Avanger2512/macropad/cad/compact/accessories/rear_feet/previews/fusion-feet-assembly.png

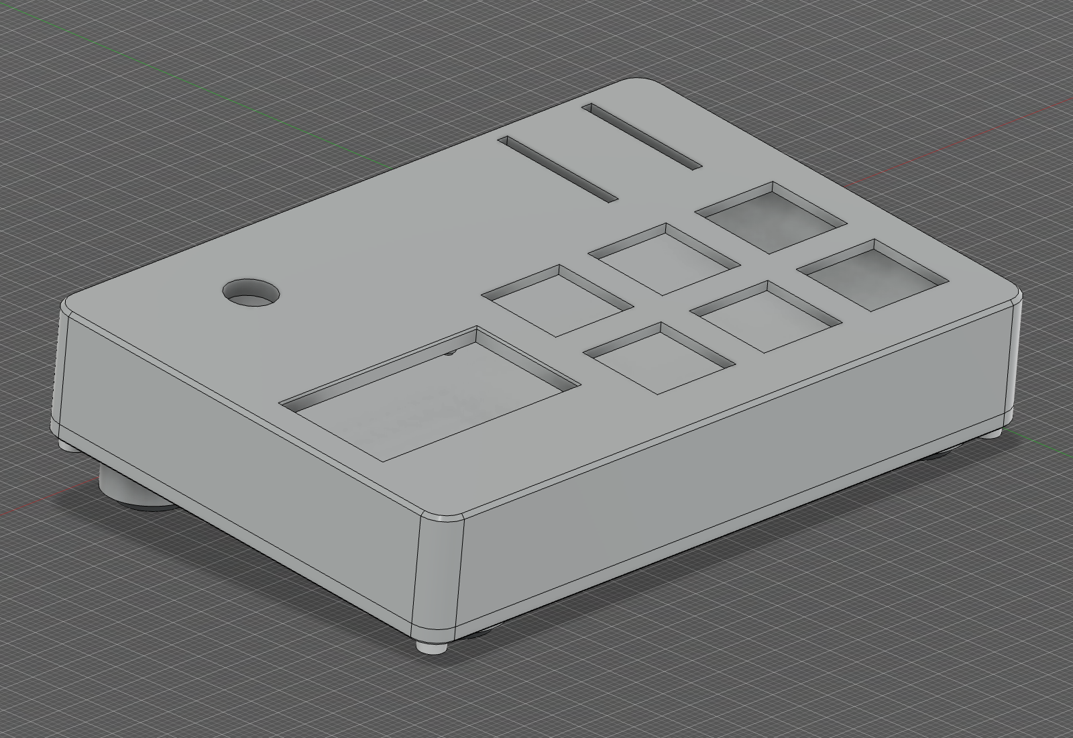
cad/compact/accessories/rear_feet/previews/fusion-feet-assembly.png
