Avanger2512/macropad/cad/compact/accessories/rear_feet/previews/front_foot_20261023T095841Z.png

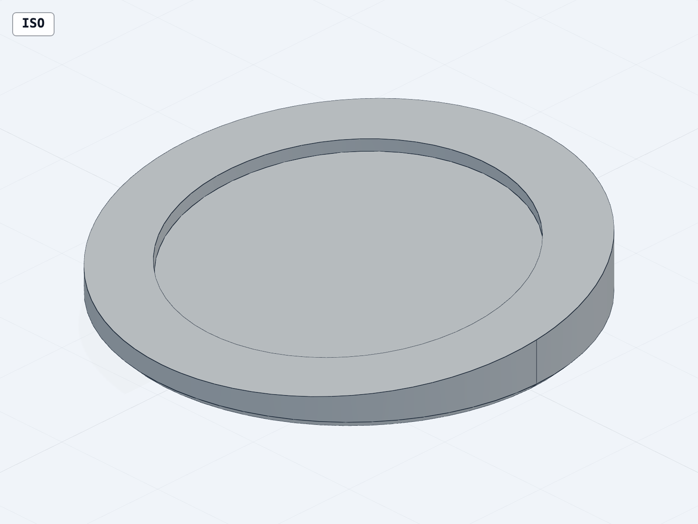
cad/compact/accessories/rear_feet/previews/front_foot_20261023T095841Z.png
