Avanger2512/macropad/cad/compact/accessories/rear_feet/previews/integrated_cover_under_20261023T105808Z.png

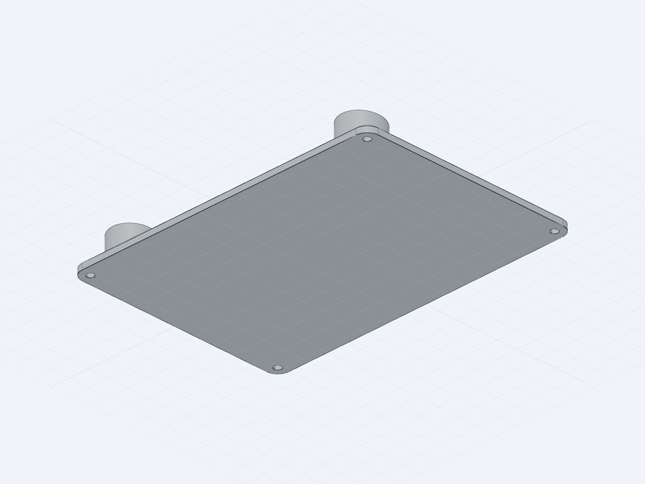
cad/compact/accessories/rear_feet/previews/integrated_cover_under_20261023T105808Z.png
