Avanger2512/macropad/cad/compact/c2/previews/c2-bottom_cover_20261022T102748Z.png

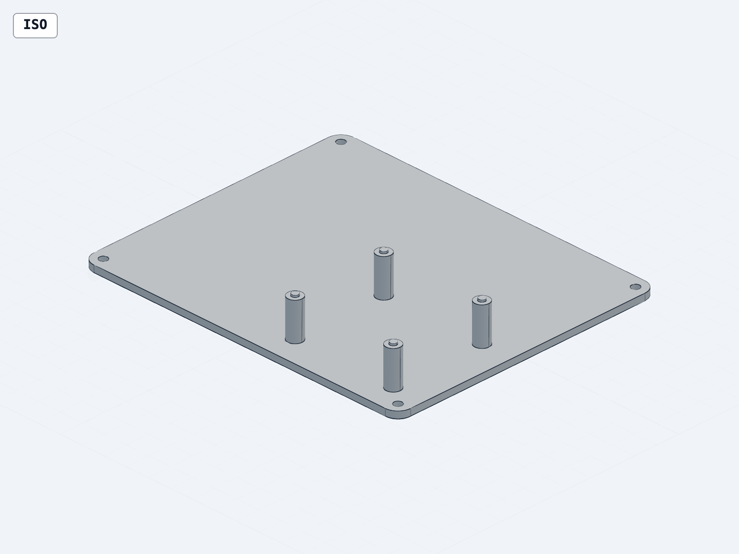
cad/compact/c2/previews/c2-bottom_cover_20261022T102748Z.png
