Avanger2512/macropad/cad/compact/c2/previews/c2-mcu_cradle_20261022T102748Z.png

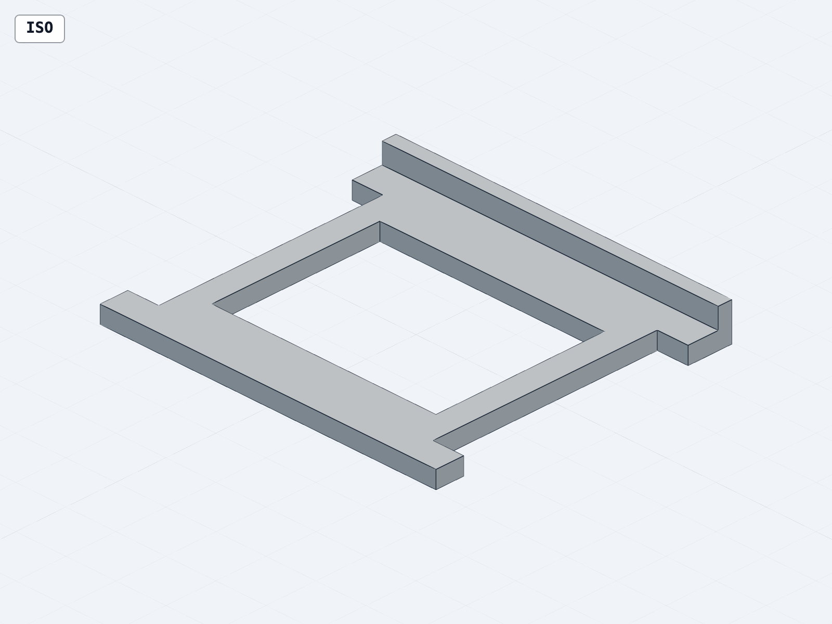
cad/compact/c2/previews/c2-mcu_cradle_20261022T102748Z.png
