Avanger2512/macropad/cad/compact/c3/previews/c3-bottom_cover_20261022T103931Z.png

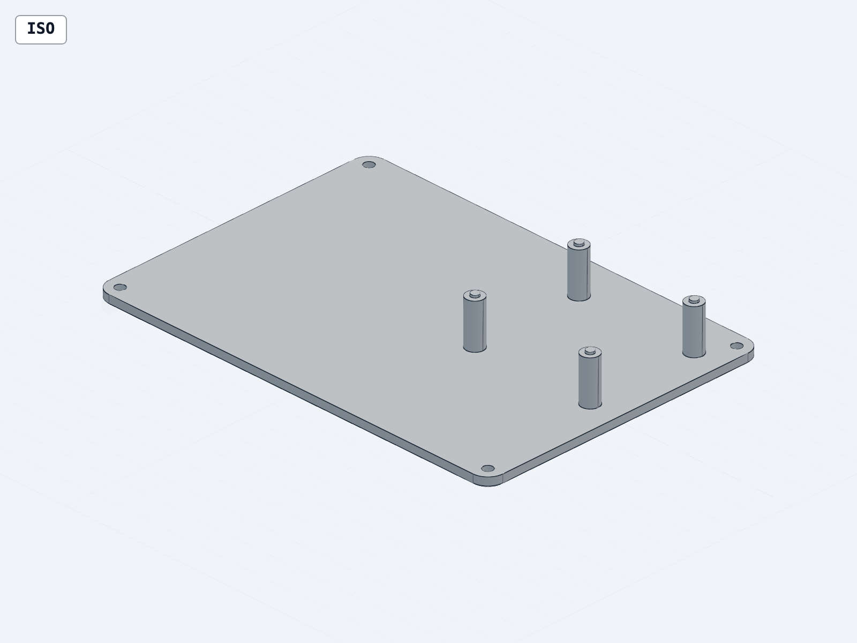
cad/compact/c3/previews/c3-bottom_cover_20261022T103931Z.png
