Avanger2512/macropad/cad/compact/c3/previews/c3-top_shell_20261022T103931Z.png

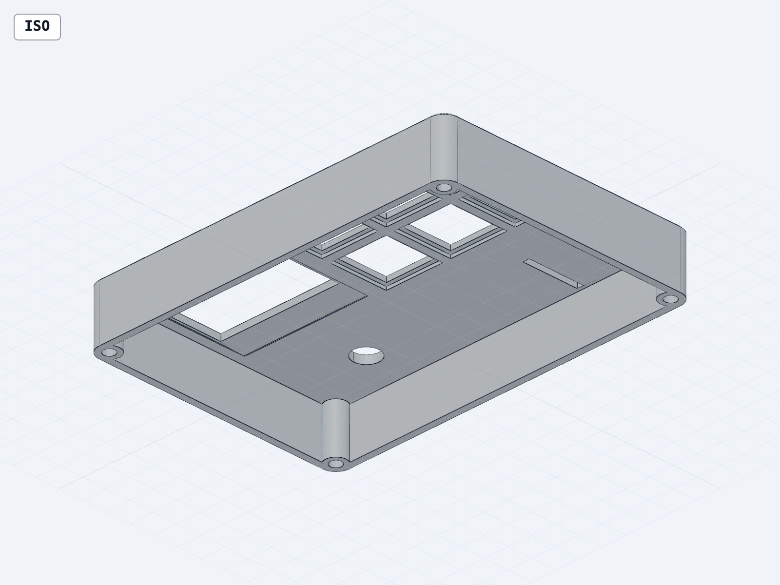
cad/compact/c3/previews/c3-top_shell_20261022T103931Z.png
