Avanger2512/macropad/cad/compact/c4/previews/c4-compact_model_20261022T130254Z.png

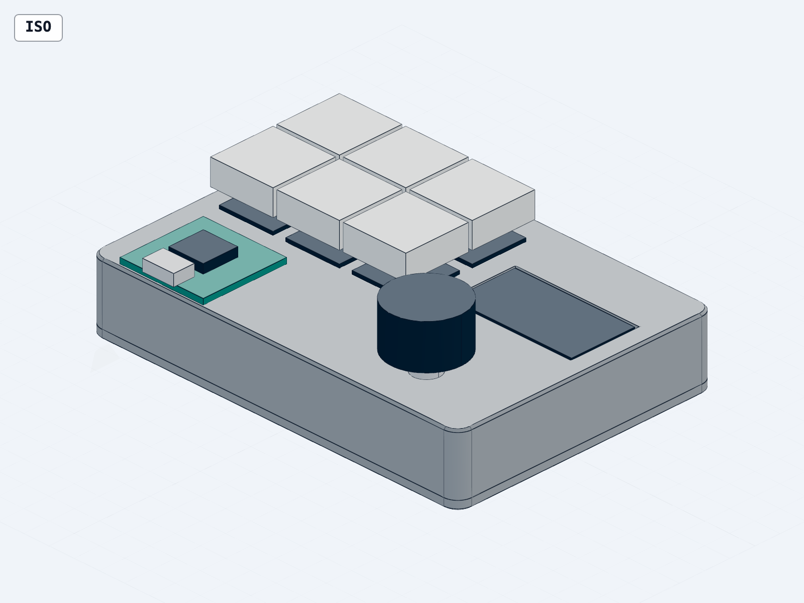
cad/compact/c4/previews/c4-compact_model_20261022T130254Z.png
