Avanger2512/macropad/cad/compact/c4/previews/c4-fusion-oled-mounts.png

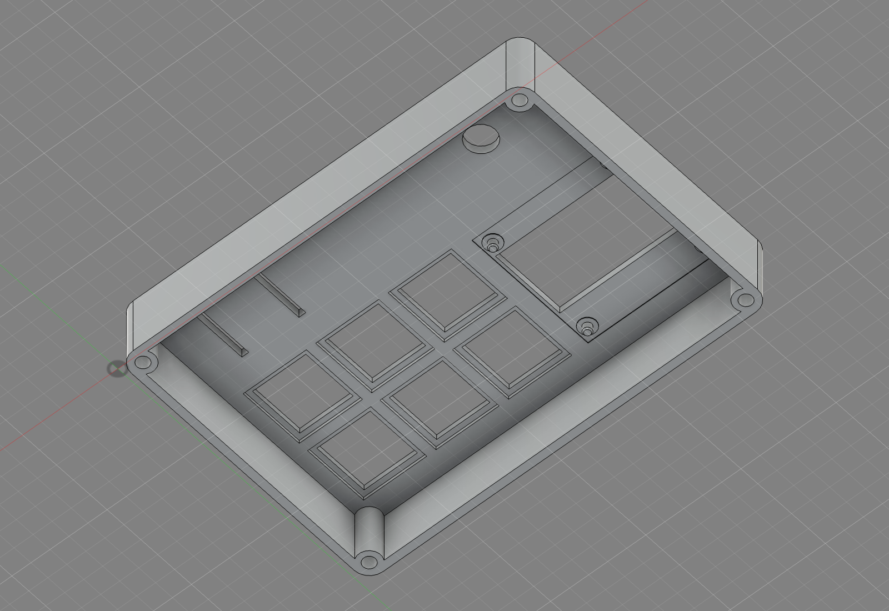
cad/compact/c4/previews/c4-fusion-oled-mounts.png
