Avanger2512/macropad/cad/compact/c4/previews/c4-mx-fit_20261022T130124Z.png

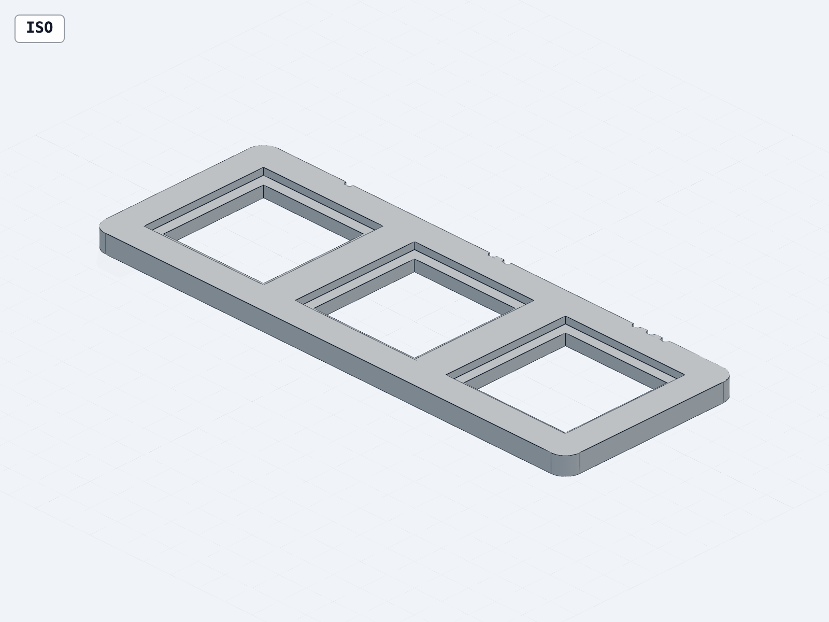
cad/compact/c4/previews/c4-mx-fit_20261022T130124Z.png
