Avanger2512/macropad/cad/compact/c5/previews/top_20261023T114638Z.png

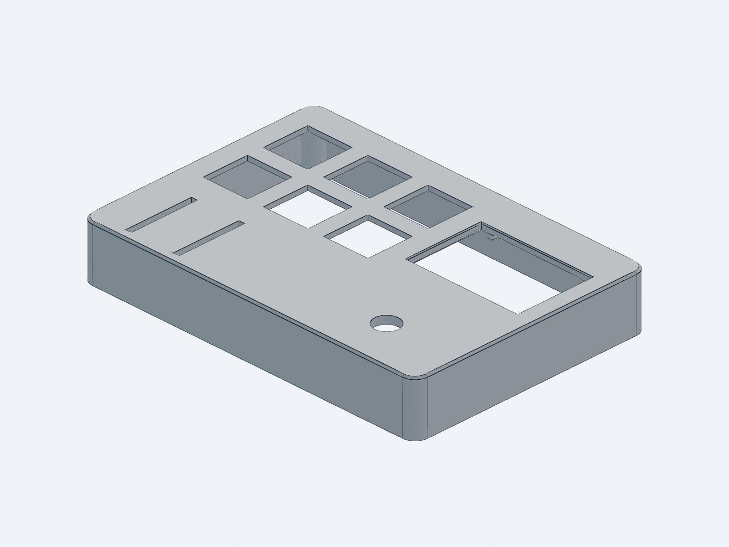
cad/compact/c5/previews/top_20261023T114638Z.png
