Avanger2512/macropad/cad/compact/previews/c1-front_20261022T092727Z.png

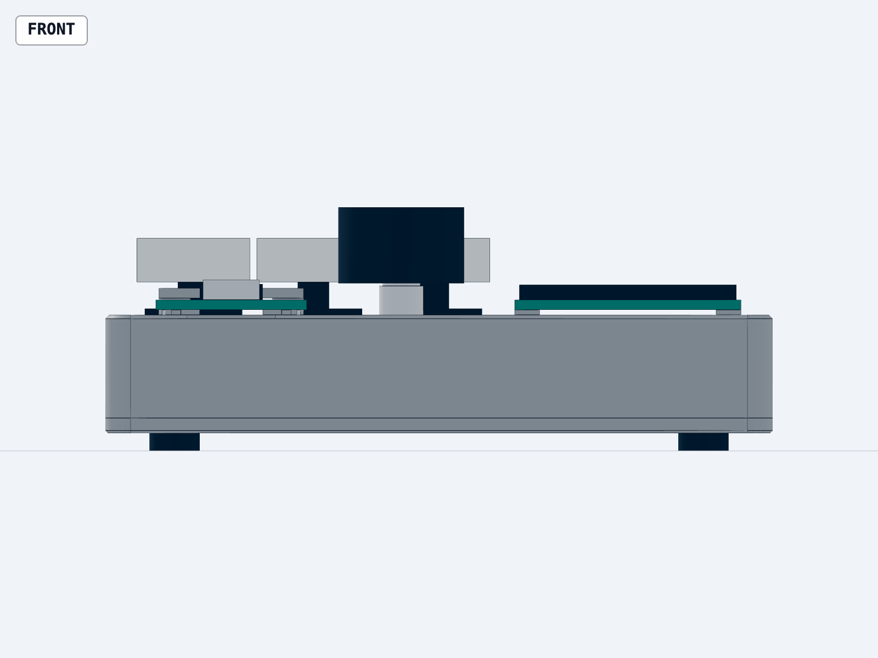
cad/compact/previews/c1-front_20261022T092727Z.png
