Avanger2512/macropad/cad/compact/previews/c1-mcu-cradle_20261022T093428Z.png

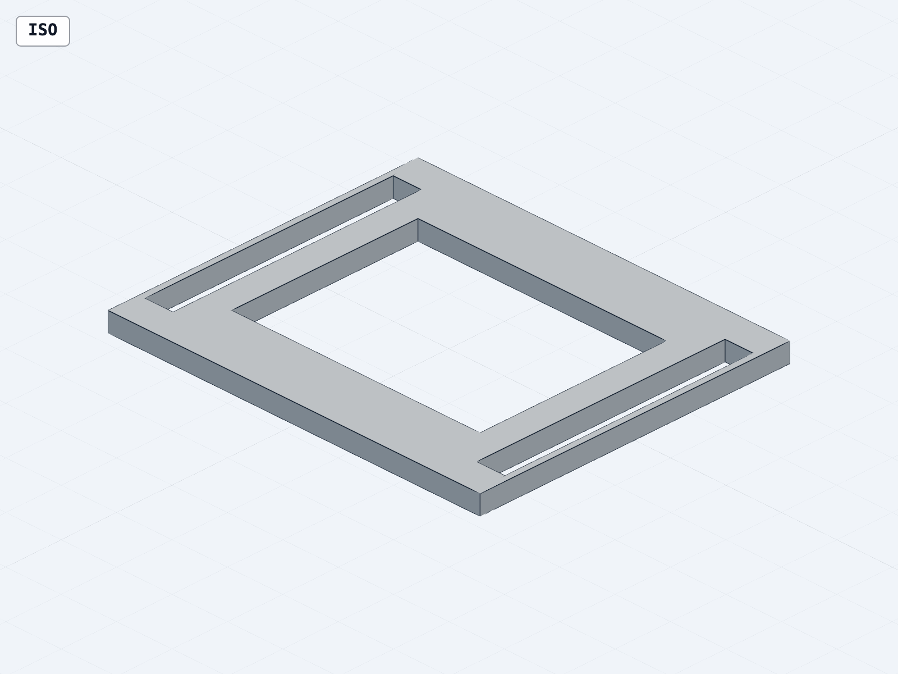
cad/compact/previews/c1-mcu-cradle_20261022T093428Z.png
