Avanger2512/macropad/cad/compact/previews/c1-oled-fusion-pins.png

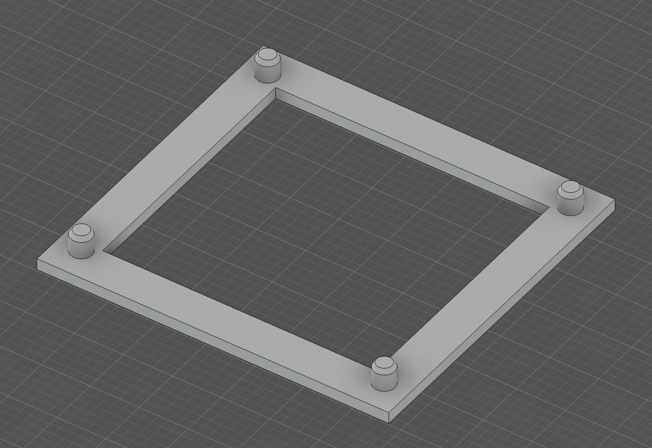
cad/compact/previews/c1-oled-fusion-pins.png
