Avanger2512/macropad/cad/compact/previews/c1-oled-pins-top_20261022T100858Z.png

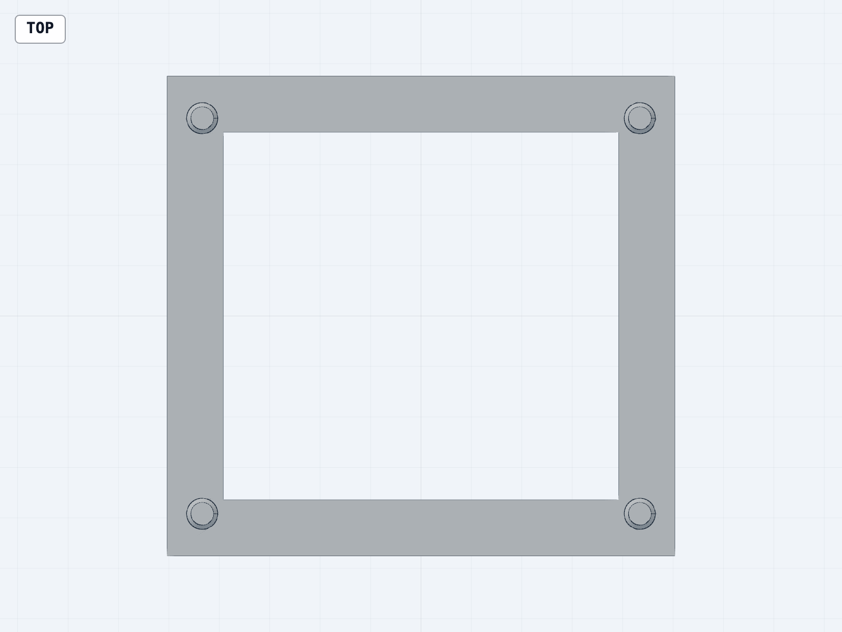
cad/compact/previews/c1-oled-pins-top_20261022T100858Z.png
