Avanger2512/macropad/cad/compact/previews/c1-opposite_20261022T092727Z.png

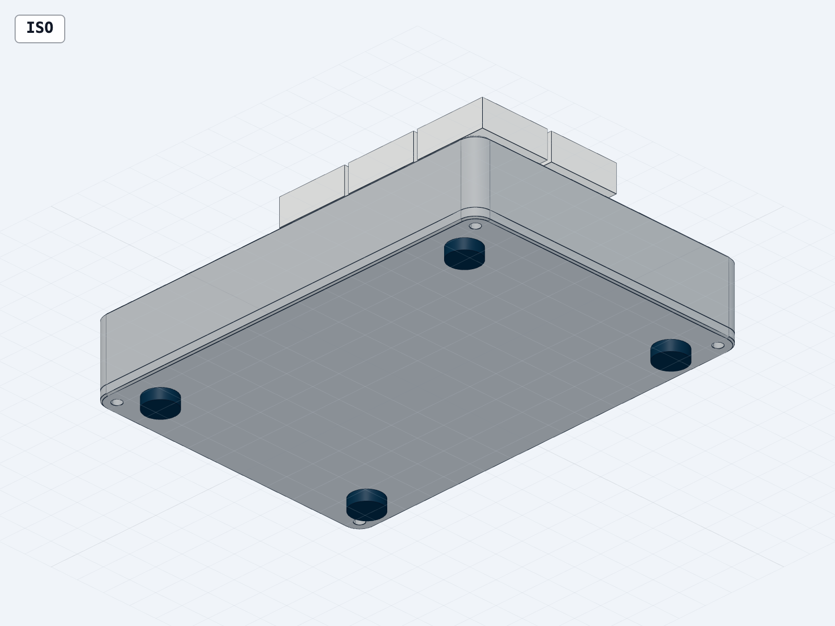
cad/compact/previews/c1-opposite_20261022T092727Z.png
