Avanger2512/macropad/cad/fusion/exports/carrier-v4-top.png

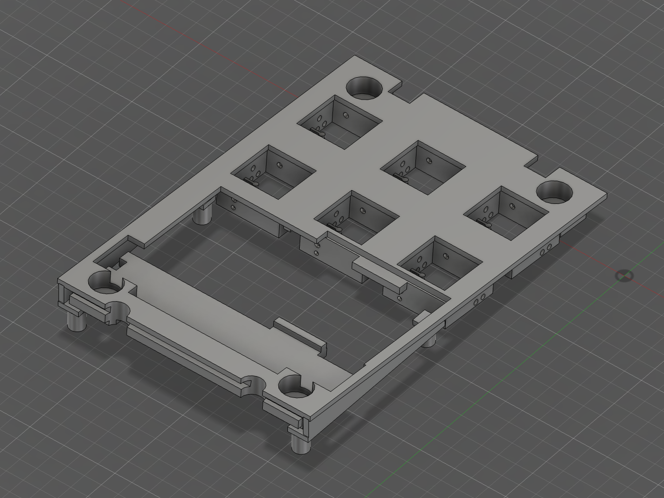
cad/fusion/exports/carrier-v4-top.png
