Avanger2512/macropad/cad/fusion/exports/carrier-v4-underneath.png

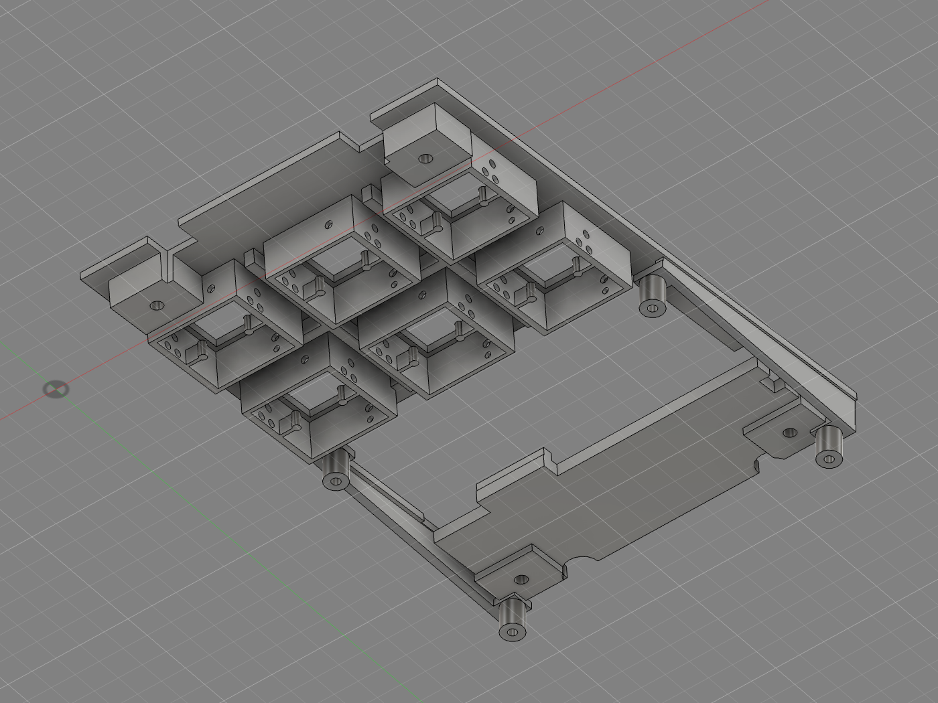
cad/fusion/exports/carrier-v4-underneath.png
