Avanger2512/macropad/cad/fusion/exports/compact-v2-receiver.png

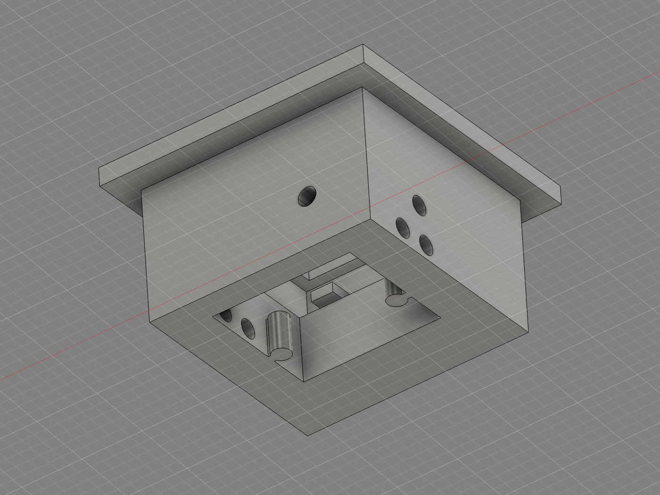
cad/fusion/exports/compact-v2-receiver.png
