Avanger2512/macropad/cad/fusion/exports/compact-v3-lid.png

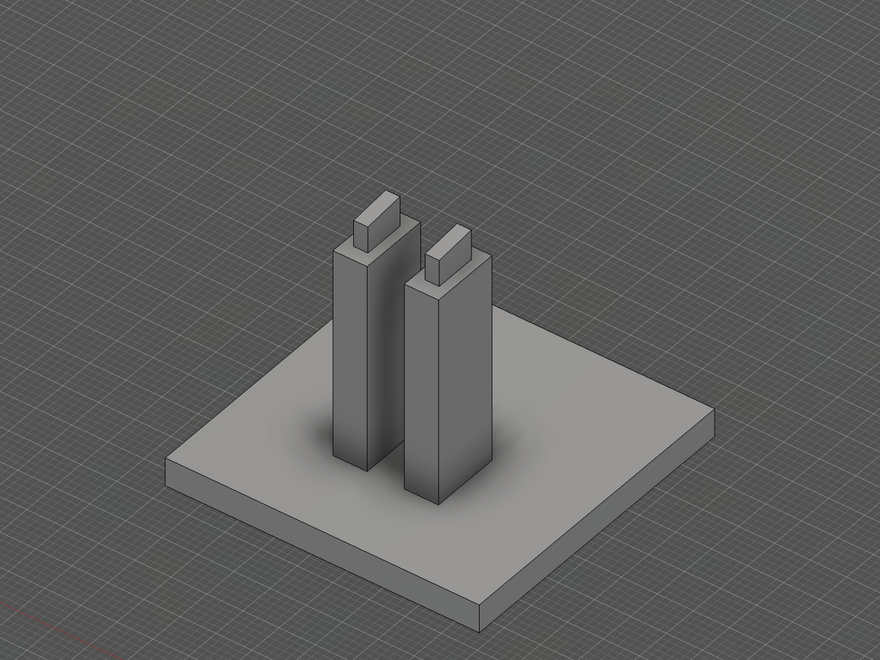
cad/fusion/exports/compact-v3-lid.png
