Avanger2512/macropad/cad/fusion/exports/compact-v3-receiver.png

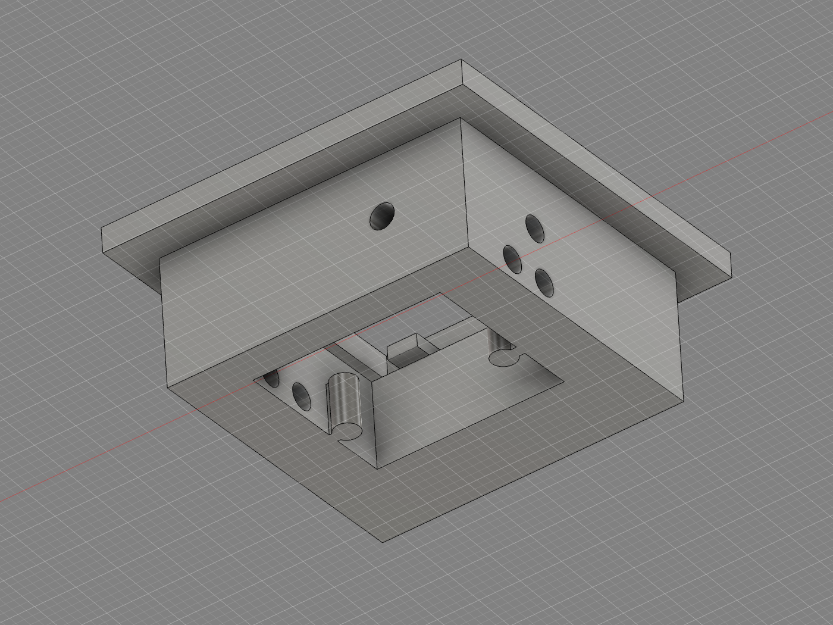
cad/fusion/exports/compact-v3-receiver.png
