Avanger2512/macropad/cad/fusion/exports/compact-v4-hotswap.png

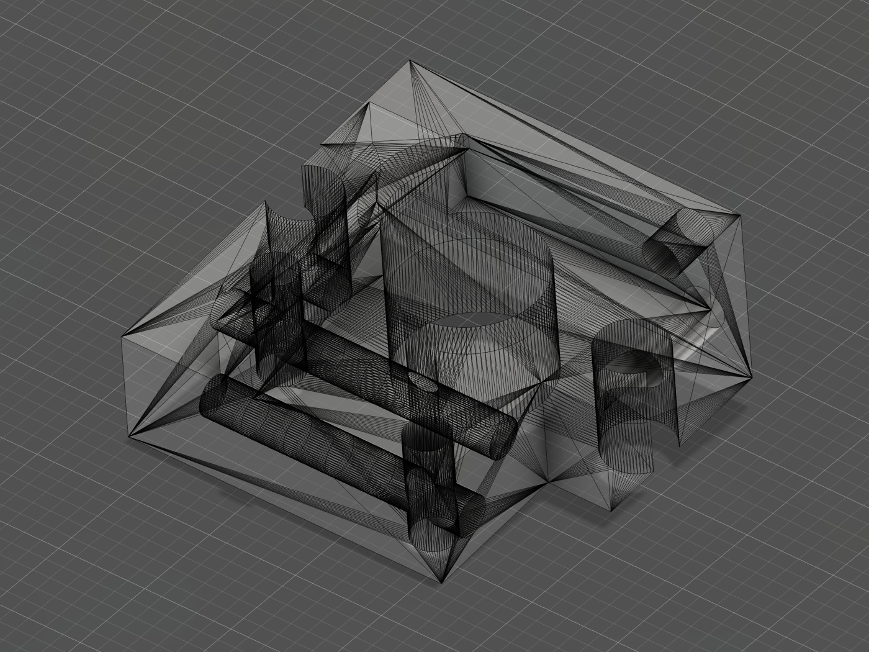
cad/fusion/exports/compact-v4-hotswap.png
