Avanger2512/macropad/cad/fusion/exports/compact-v4-receiver.png

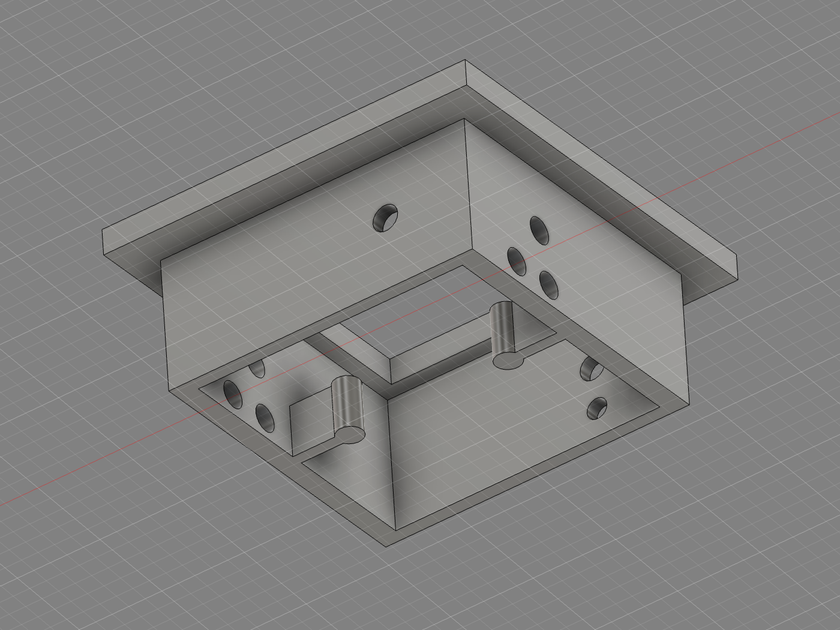
cad/fusion/exports/compact-v4-receiver.png
