Avanger2512/macropad/cad/fusion/exports/cover-mounts-v7-interior.png

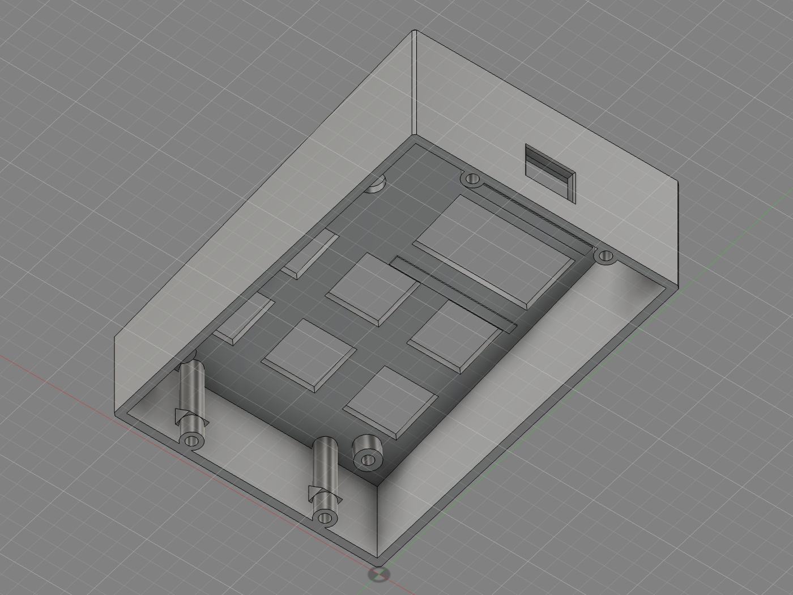
cad/fusion/exports/cover-mounts-v7-interior.png
