Avanger2512/macropad/cad/fusion/exports/enclosure-v6-bottom.png

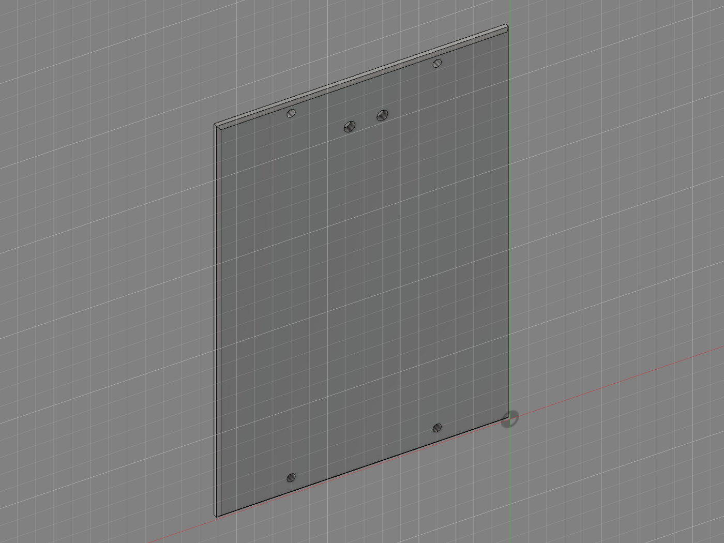
cad/fusion/exports/enclosure-v6-bottom.png
