Avanger2512/macropad/cad/fusion/exports/enclosure-v6-rear.png

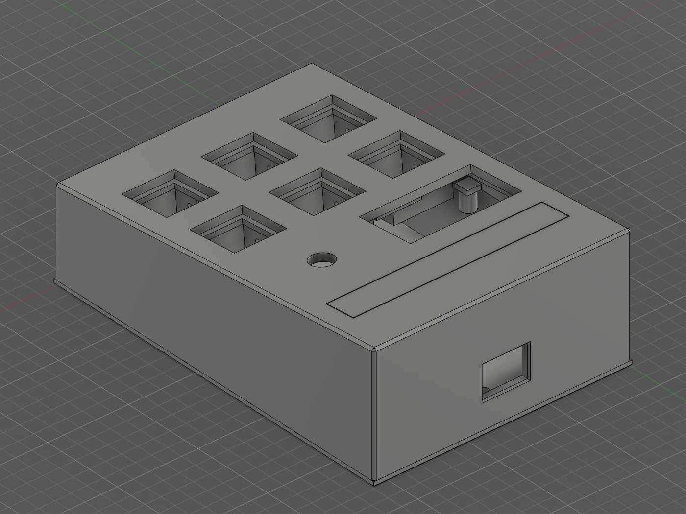
cad/fusion/exports/enclosure-v6-rear.png
