Avanger2512/macropad/cad/fusion/exports/macropad-draft-iso.png

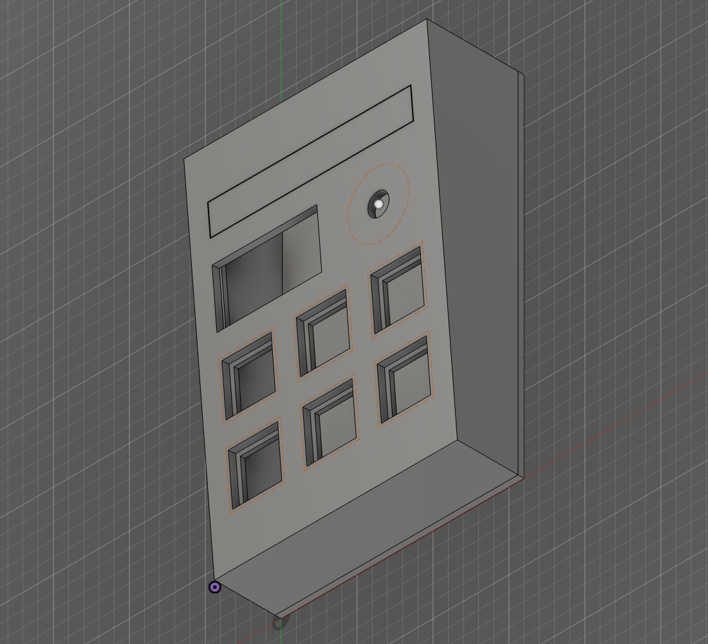
cad/fusion/exports/macropad-draft-iso.png
