Avanger2512/macropad/cad/fusion/exports/macropad-iteration2-carrier.png

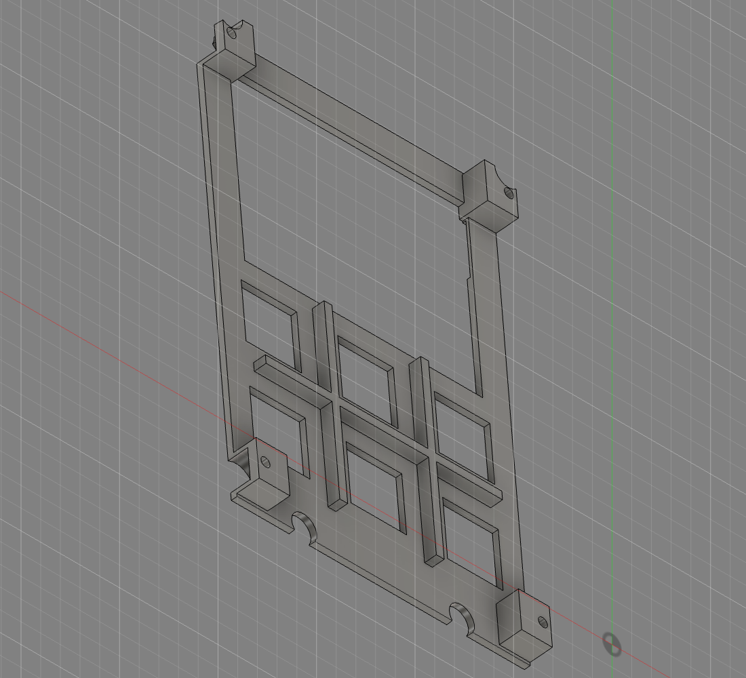
cad/fusion/exports/macropad-iteration2-carrier.png
