Avanger2512/macropad/cad/fusion/exports/macropad-iteration2-interior.png

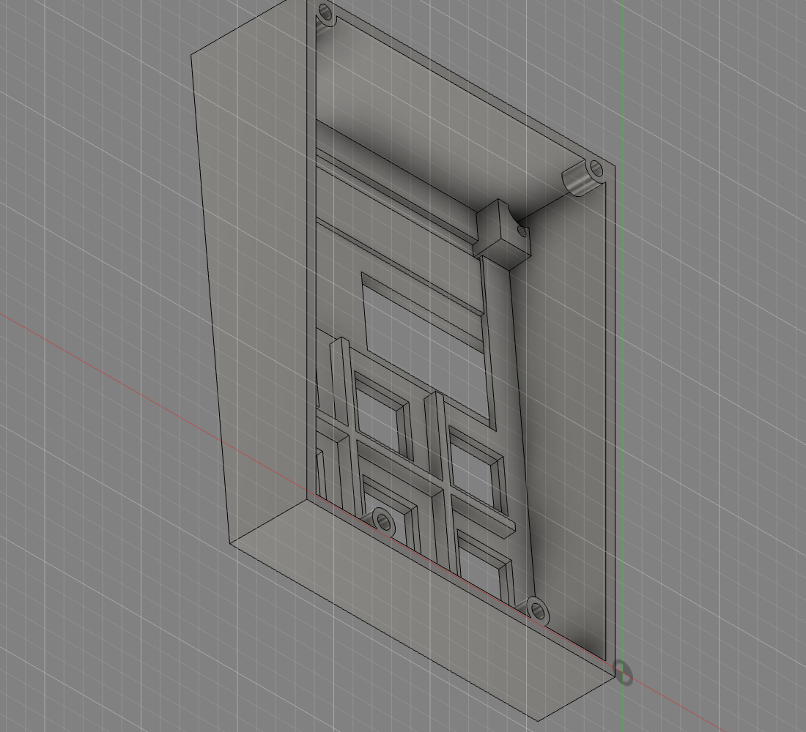
cad/fusion/exports/macropad-iteration2-interior.png
