Avanger2512/macropad/cad/fusion/exports/macropad-iteration3-interior.png

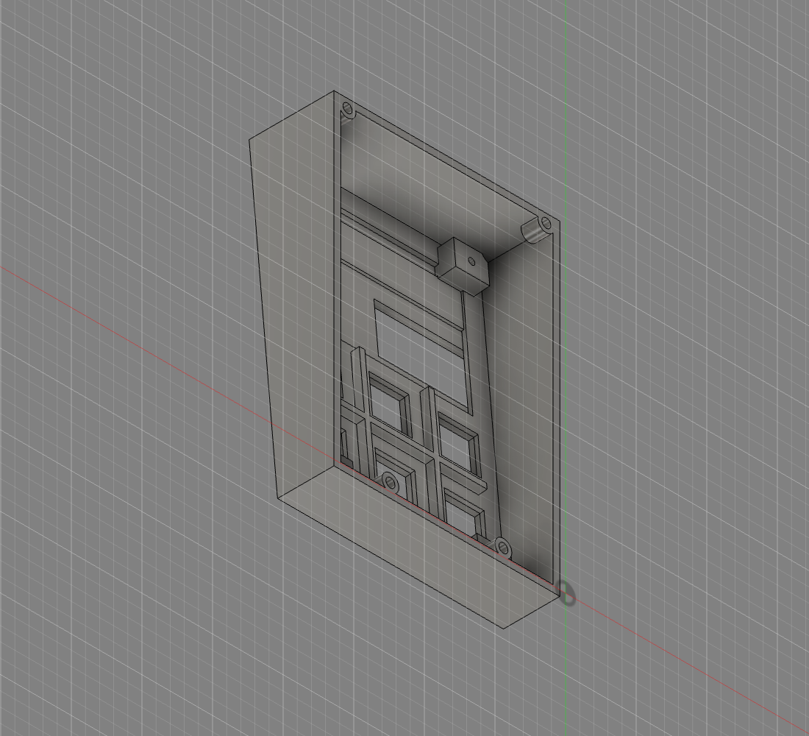
cad/fusion/exports/macropad-iteration3-interior.png
