Avanger2512/macropad/cad/fusion/exports/macropad-pcb-layout.png

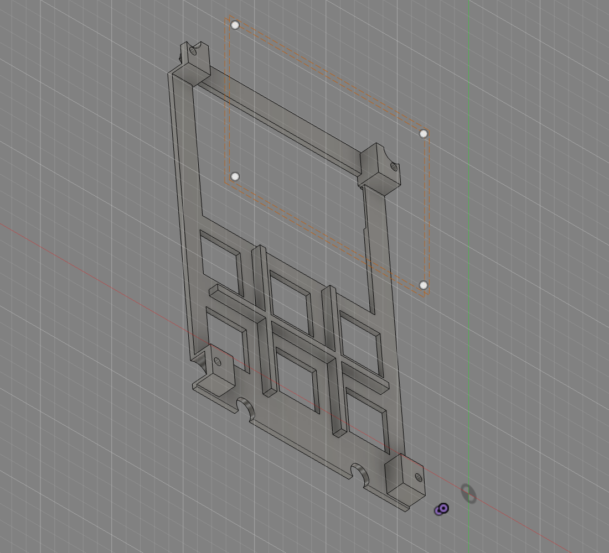
cad/fusion/exports/macropad-pcb-layout.png
