Avanger2512/macropad/cad/fusion/exports/macropad-pcb-mount-revision.png

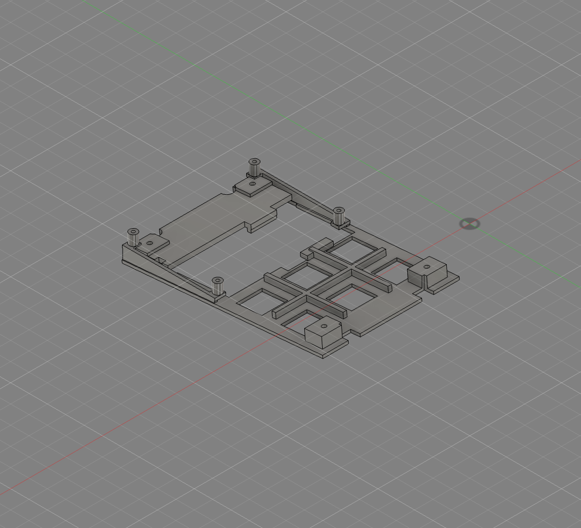
cad/fusion/exports/macropad-pcb-mount-revision.png
