Avanger2512/macropad/cad/fusion/exports/macropad-switch-retention-carrier.png

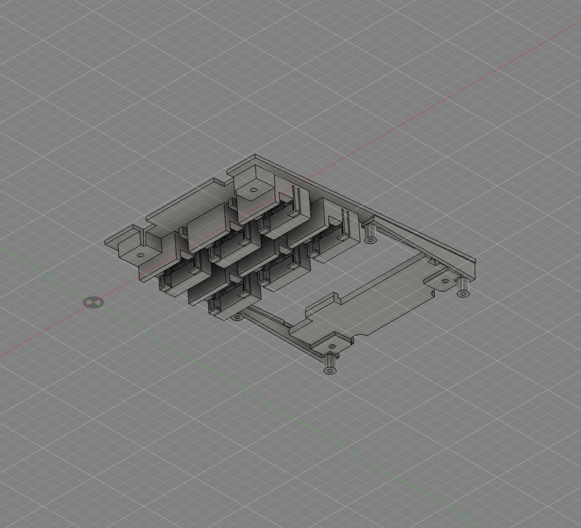
cad/fusion/exports/macropad-switch-retention-carrier.png
