Avanger2512/macropad/cad/fusion/exports/macropad-switch-retention-lid.png

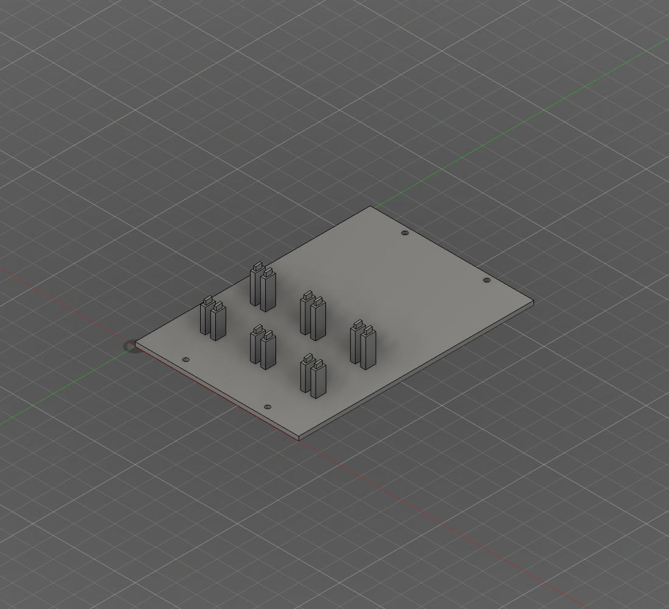
cad/fusion/exports/macropad-switch-retention-lid.png
