Avanger2512/macropad/cad/fusion/exports/through-pin-v5-holder.png

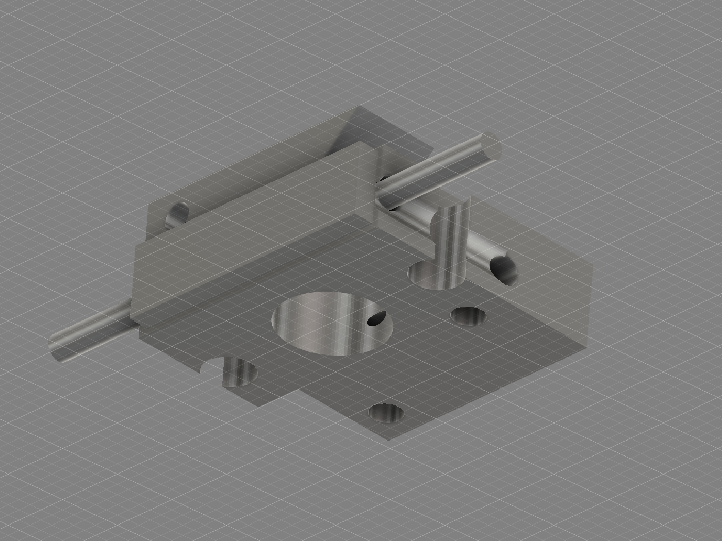
cad/fusion/exports/through-pin-v5-holder.png
