Avanger2512/macropad/cad/compact/accessories/rear_feet/bottom_cover_with_feet.step

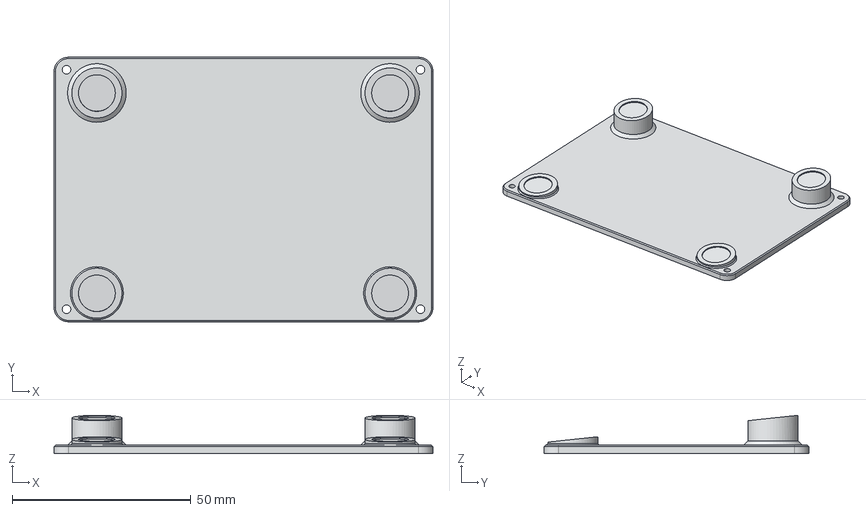
[picture p48: CAD file, 2026-10-24]
cad/compact/accessories/rear_feet/bottom_cover_with_feet.step
106.0 x 74.0 x 10.7 mm
