Avanger2512/macropad/cad/compact/c2/bottom_cover.step

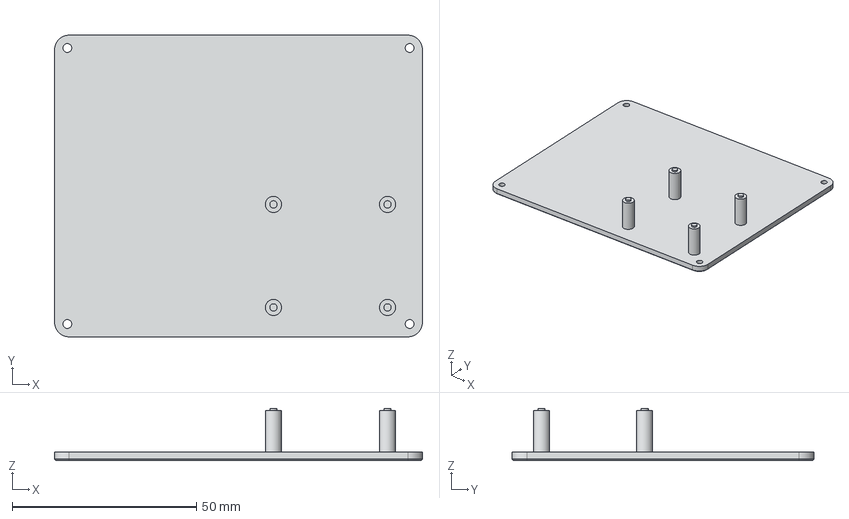
[picture p49: CAD file, 2026-10-22]
cad/compact/c2/bottom_cover.step
100.0 x 82.0 x 14.2 mm
