Avanger2512/macropad/cad/compact/c3/oled_cradle.step

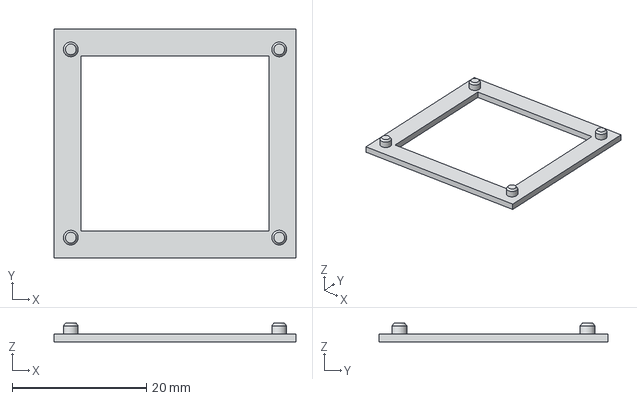
[picture p50: CAD file, 2026-10-22]
cad/compact/c3/oled_cradle.step
36.0 x 34.0 x 2.80 mm
