Avanger2512/macropad/cad/compact/c4/top_shell.step

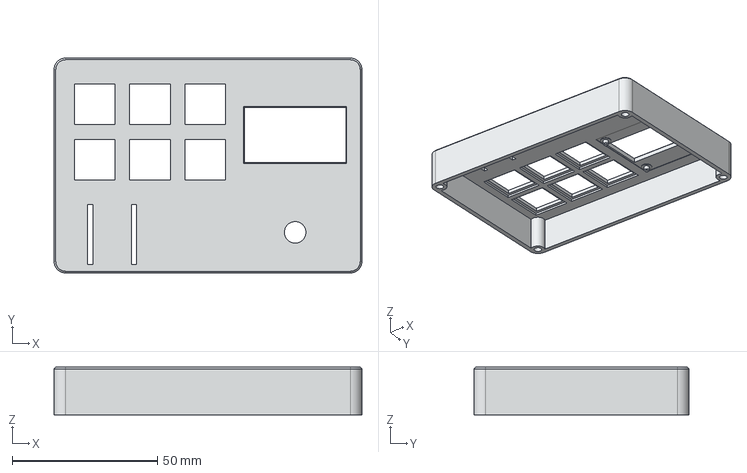
[picture p51: CAD file, 2026-10-22]
cad/compact/c4/top_shell.step
106.0 x 74.0 x 16.4 mm
