Avanger2512/macropad/cad/fusion/exports/upper_shell_finish_v6.step

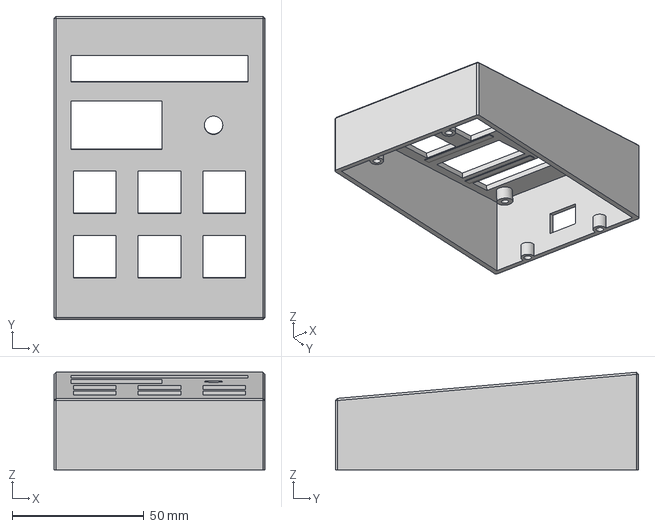
[picture p52: CAD file, 2026-10-20]
cad/fusion/exports/upper_shell_finish_v6.step
80.0 x 115.0 x 37.0 mm
