Avanger2512/macropad/cad/hotswap_mx__compact.stl

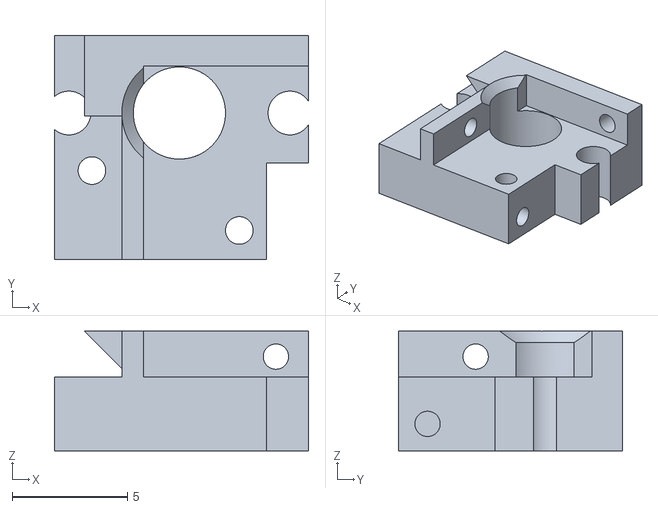
[picture p53: CAD file, 2026-10-13]
cad/hotswap_mx__compact.stl
11.0 x 9.75 x 5.20
