Avanger2512/macropad/cad/compact/accessories/rear_feet/rear_foot.step

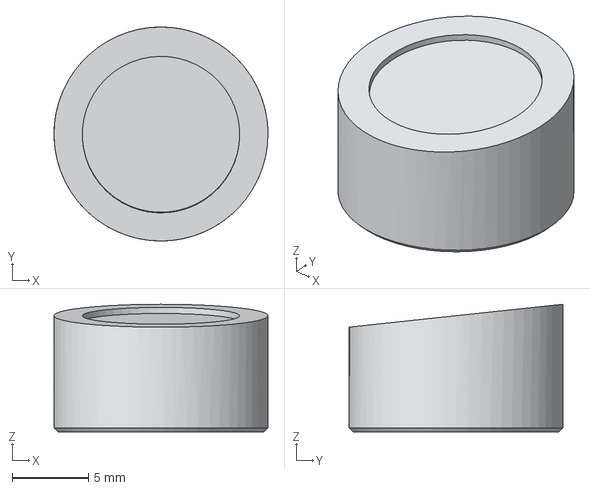
[picture p54: CAD file, 2026-10-24]
cad/compact/accessories/rear_feet/rear_foot.step
14.0 x 14.0 x 8.34 mm
