Avanger2512/macropad/cad/compact/oled_cradle.step

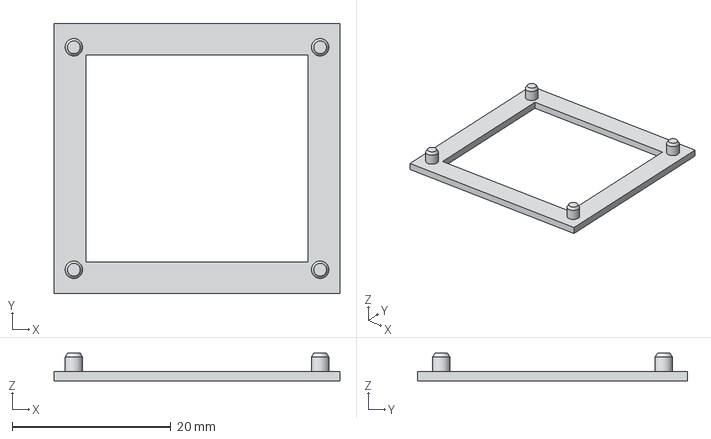
[picture p56: CAD file, 2026-10-22]
cad/compact/oled_cradle.step
36.0 x 34.0 x 3.50 mm
