Avanger2512/macropad/cad/fusion/exports/hotswap_mx_through_pin_v5_native.stl

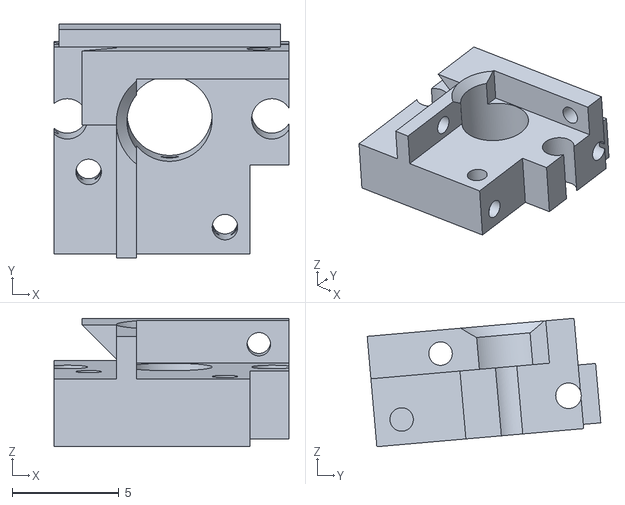
[picture p57: CAD file, 2026-10-20]
cad/fusion/exports/hotswap_mx_through_pin_v5_native.stl
11.0 x 11.0 x 6.03
