Avanger2512/macropad/cad/whotswap-MX-v2.3mf

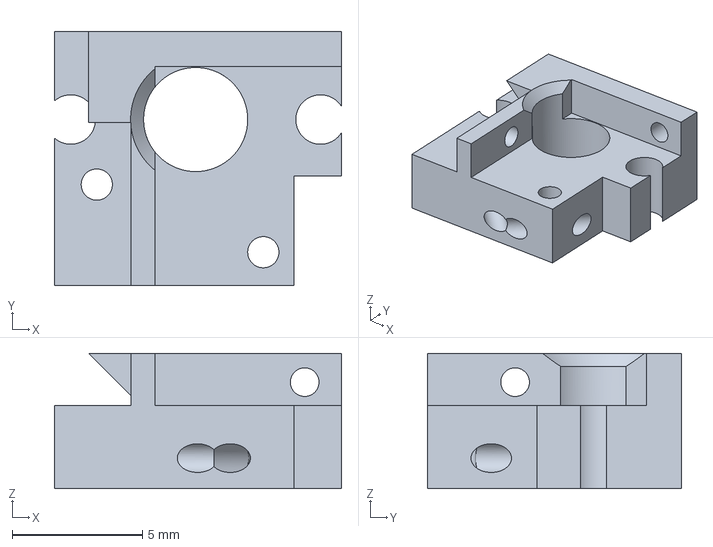
[picture p58: CAD file, 2026-10-12]
cad/whotswap-MX-v2.3mf
11.0 x 9.75 x 5.20 mm
