Avanger2512/macropad/cad/choc.stl

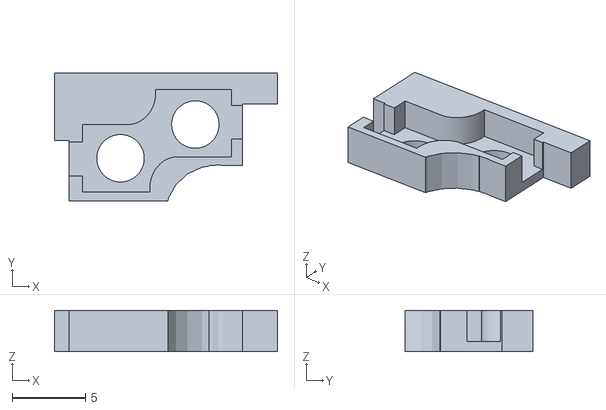
[picture p59: CAD file, 2026-10-12]
cad/choc.stl
15.2 x 8.70 x 2.80
