Avanger2512/macropad/cad/compact/accessories/rear_feet/fitted_case.step

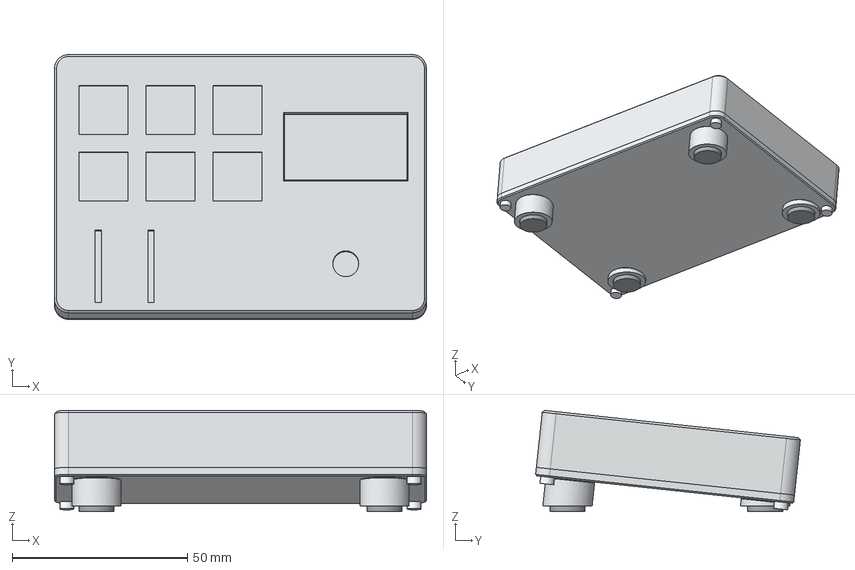
[picture p60: CAD file, 2026-10-24]
cad/compact/accessories/rear_feet/fitted_case.step
106.0 x 75.5 x 28.8 mm
REFERENCE existing C4 top_shell
REFERENCE existing C4 bottom_cover
Rear raised wedge foot - adhesive mount D10 pad left
Rear raised wedge foot - adhesive mount D10 pad right
Front low wedge foot - adhesive mount D10 pad left
Front low wedge foot - adhesive mount D10 pad right
REFERENCE rubber pad - user measured D10 x2 x 4
REFERENCE existing screw head D4 x2 x 4
