Avanger2512/macropad/cad/compact/c2/mcu_cradle.step

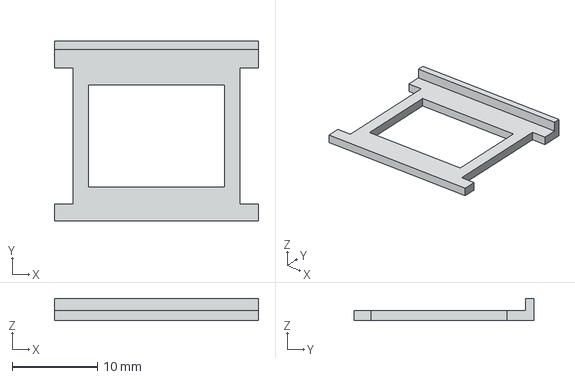
[picture p61: CAD file, 2026-10-22]
cad/compact/c2/mcu_cradle.step
24.0 x 21.1 x 2.60 mm
