Avanger2512/macropad/cad/compact/c3/bottom_cover.step

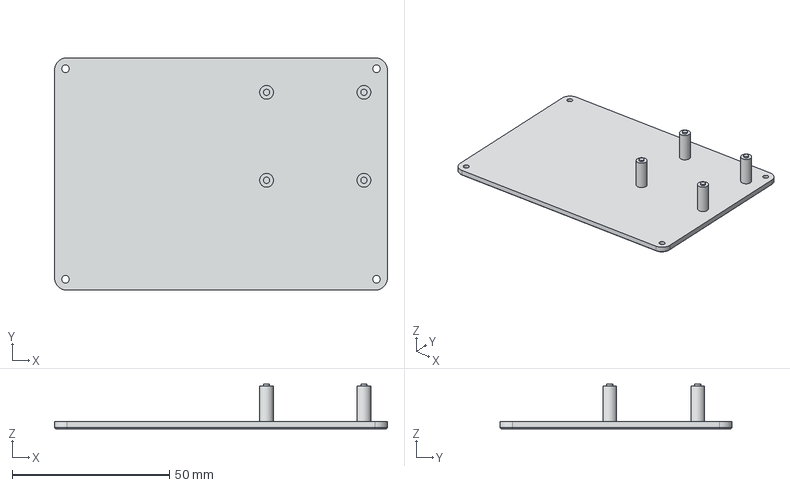
[picture p62: CAD file, 2026-10-22]
cad/compact/c3/bottom_cover.step
106.0 x 74.0 x 14.2 mm
