Avanger2512/macropad/cad/compact/c4/bottom_cover.step

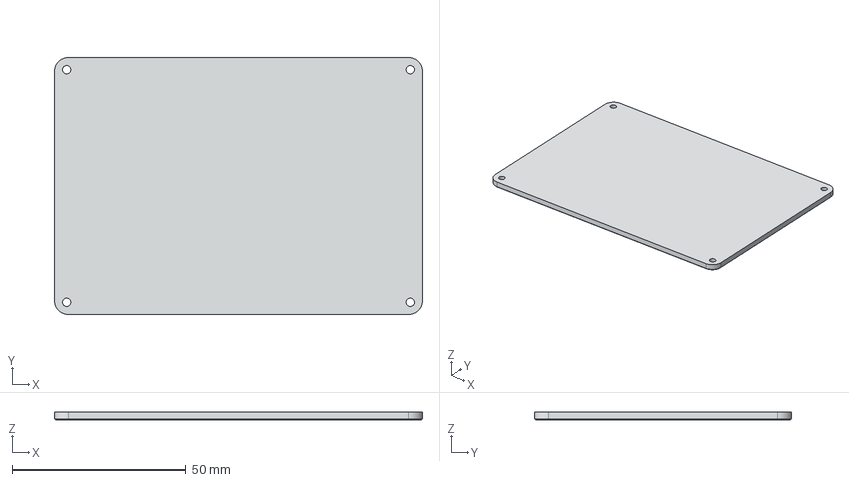
[picture p63: CAD file, 2026-10-22]
cad/compact/c4/bottom_cover.step
106.0 x 74.0 x 2.40 mm
