Avanger2512/macropad/cad/compact/compact_model.step

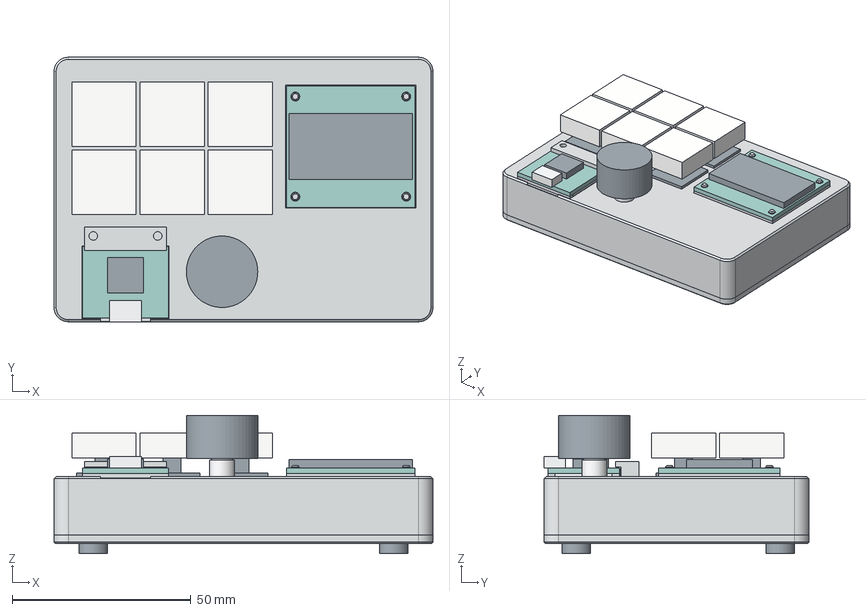
[picture p64: CAD file, 2026-10-22]
cad/compact/compact_model.step
106.0 x 74.0 x 38.7 mm
C1 top shell - provisional electronics seats
C1 removable lower cover - M2 clearance
C1 removable MCU strap - edge clearance provisional
C1 OLED cradle - 31x28 locating pins diameter 2.2
C1 replaceable MCU cradle - provisional
REFERENCE MX 1 - assumed depth
REFERENCE cap 1 - 18 mm measured footprint
REFERENCE switch 1 solder pin x 2
REFERENCE MX 2 - assumed depth
REFERENCE cap 2 - 18 mm measured footprint
REFERENCE switch 2 solder pin x 2
REFERENCE MX 3 - assumed depth
REFERENCE cap 3 - 18 mm measured footprint
REFERENCE switch 3 solder pin x 2
REFERENCE MX 4 - assumed depth
REFERENCE cap 4 - 18 mm measured footprint
REFERENCE switch 4 solder pin x 2
REFERENCE MX 5 - assumed depth
REFERENCE cap 5 - 18 mm measured footprint
REFERENCE switch 5 solder pin x 2
REFERENCE MX 6 - assumed depth
REFERENCE cap 6 - 18 mm measured footprint
REFERENCE switch 6 solder pin x 2
REFERENCE OLED PCB - measured holes 31x28 diameter 2.5
REFERENCE OLED glass - offset provisional
REFERENCE ESP32-S3 SuperMini - provisional outline
REFERENCE ESP32 components - provisional
REFERENCE USB connector - provisional
REFERENCE MCU downward pins - provisional x 2
REFERENCE KY040 PCB - centered axis provisional
REFERENCE encoder body - assumed
REFERENCE measured encoder bushing diameter 7 length 7
REFERENCE encoder shaft - provisional
REFERENCE encoder knob - diameter provisional
REFERENCE rubber foot - effective height 2.8 x 4
