Avanger2512/macropad/cad/compact/accessories/rear_feet/feet_set.step

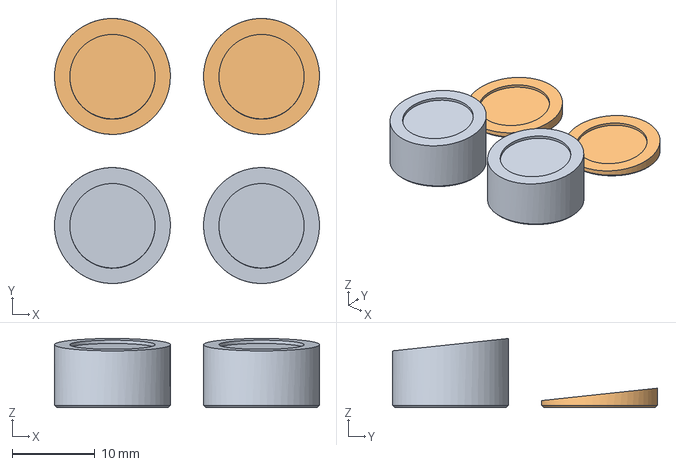
[picture p65: CAD file, 2026-10-24]
cad/compact/accessories/rear_feet/feet_set.step
32.0 x 32.0 x 8.34 mm
Rear raised wedge foot - adhesive mount D10 pad x 2
Front low wedge foot - adhesive mount D10 pad x 2
