Avanger2512/macropad/cad/compact/c2/top_shell.step

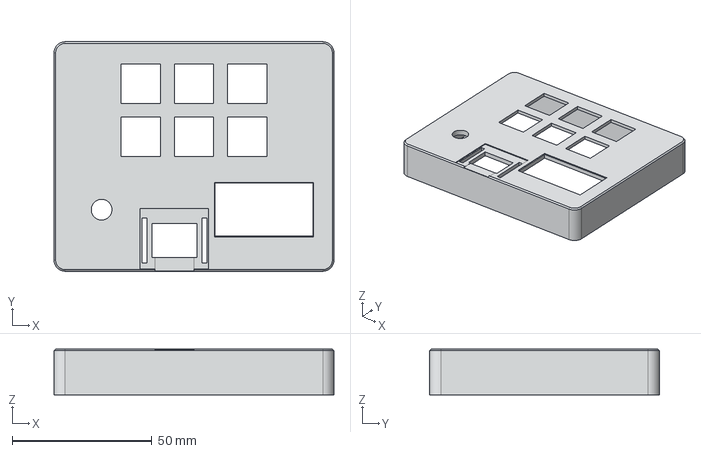
[picture p66: CAD file, 2026-10-22]
cad/compact/c2/top_shell.step
100.0 x 82.0 x 16.4 mm
