Avanger2512/macropad/cad/compact/c4/mx_coupon.step

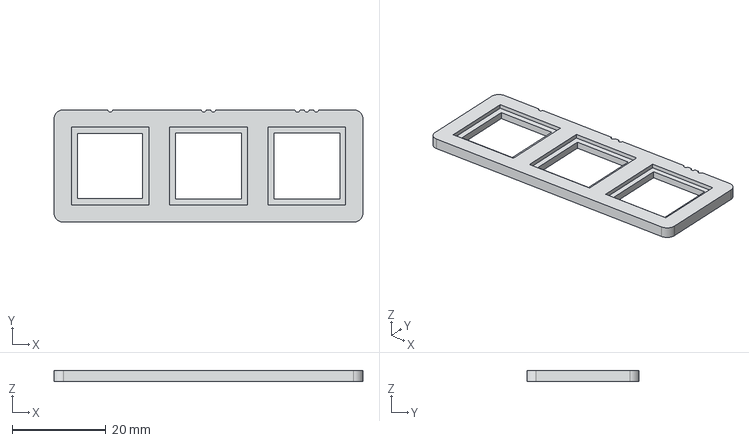
[picture p67: CAD file, 2026-10-22]
cad/compact/c4/mx_coupon.step
66.0 x 24.0 x 2.40 mm
