Avanger2512/macropad/cad/compact/mx_coupon.step

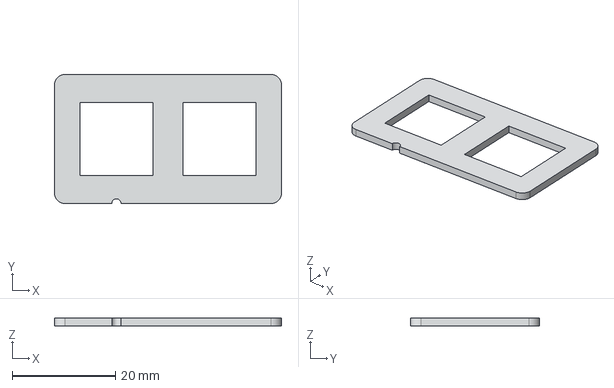
[picture p68: CAD file, 2026-10-22]
cad/compact/mx_coupon.step
44.0 x 25.0 x 1.50 mm
