Avanger2512/macropad/cad/fusion/exports/bottom_cover_finish_v6.step

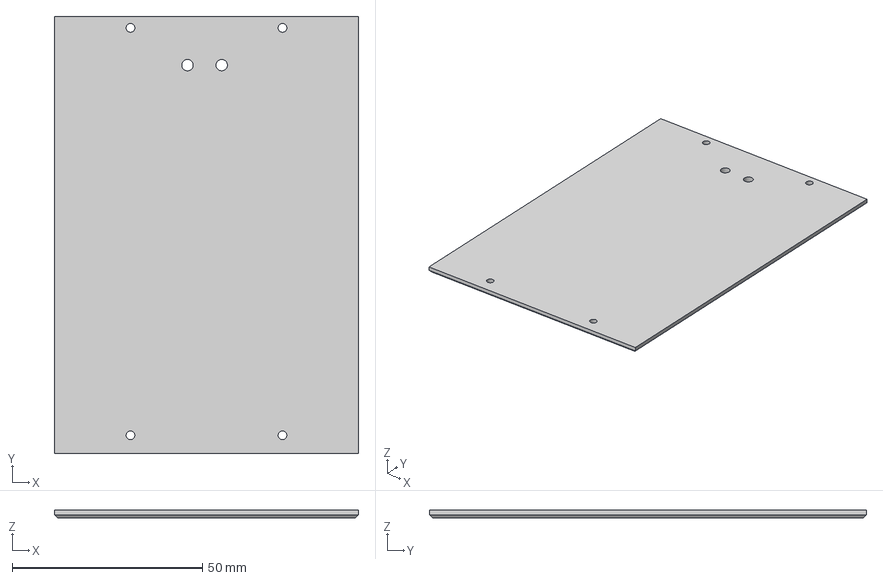
[picture p69: CAD file, 2026-10-20]
cad/fusion/exports/bottom_cover_finish_v6.step
80.0 x 115.0 x 2.00 mm
