Avanger2512/macropad/cad/MX.stl

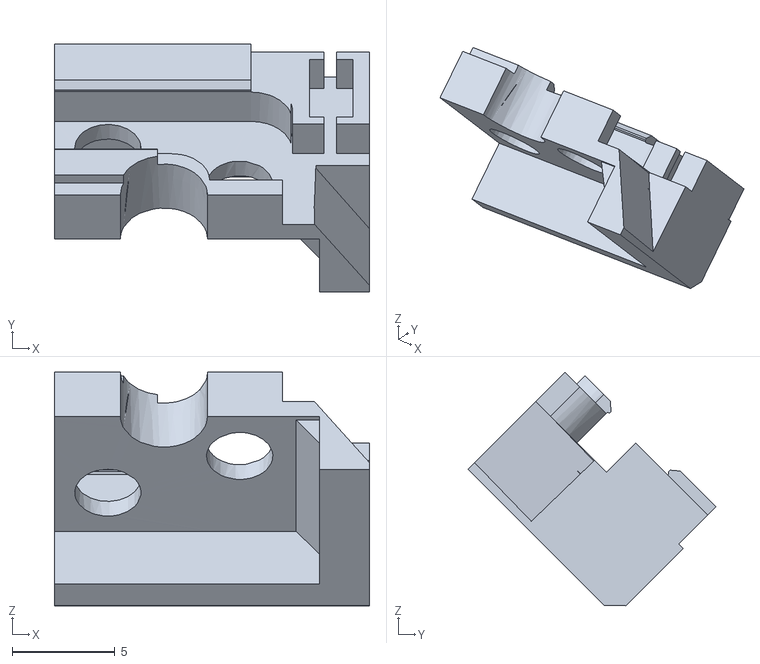
[picture p70: CAD file, 2026-10-12]
cad/MX.stl
15.4 x 12.1 x 11.4
