Avanger2512/macropad/cad/compact/accessories/rear_feet/front_foot.step

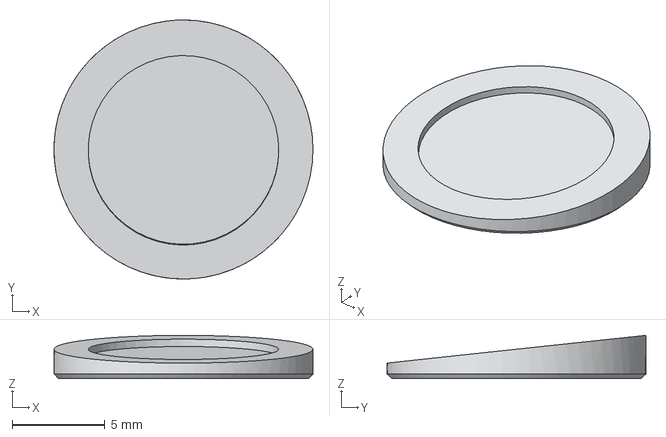
[picture p71: CAD file, 2026-10-24]
cad/compact/accessories/rear_feet/front_foot.step
14.0 x 14.0 x 2.34 mm
