Avanger2512/macropad/cad/compact/mcu_cradle.step

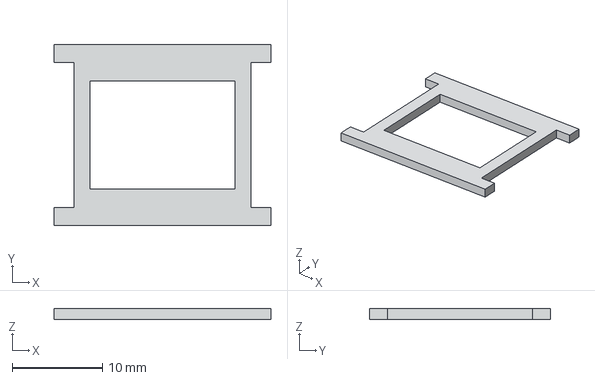
[picture p74: CAD file, 2026-10-22]
cad/compact/mcu_cradle.step
24.0 x 20.0 x 1.20 mm
