Avanger2512/macropad/cad/hotswap_mx__with_wing.stl

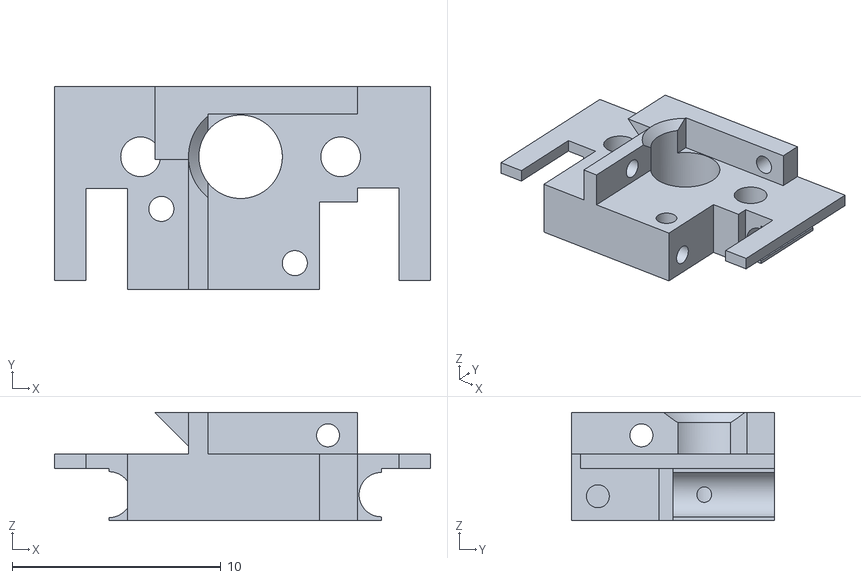
[picture p75: CAD file, 2026-10-12]
cad/hotswap_mx__with_wing.stl
18.0 x 9.75 x 5.20
