Avanger2512/macropad/cad/fusion/exports/middle_carrier_through_pin_v5_native.stl

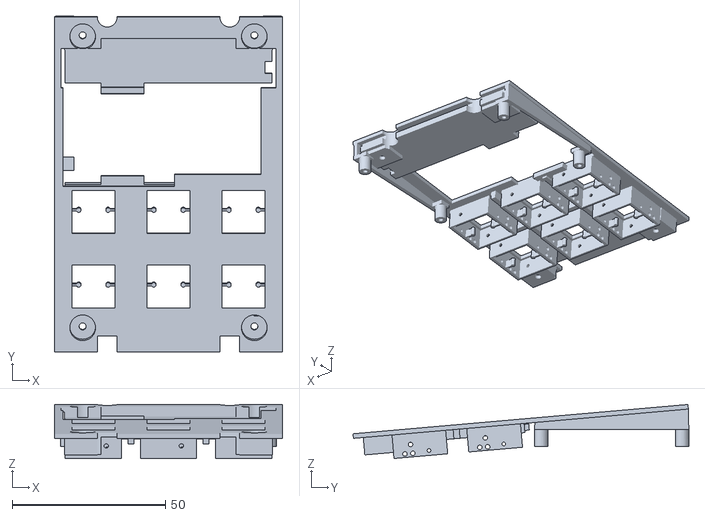
[picture p76: CAD file, 2026-10-20]
cad/fusion/exports/middle_carrier_through_pin_v5_native.stl
74.4 x 109.6 x 17.6
