Avanger2512/macropad/cad/print/Diffuser_Service_V8.stl

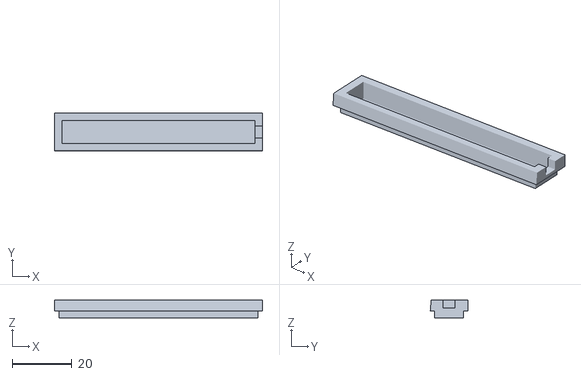
[picture p77: CAD file, 2026-10-20]
cad/print/Diffuser_Service_V8.stl
69.6 x 12.6 x 6.00
