Avanger2512/macropad/cad/compact/mcu_strap.step

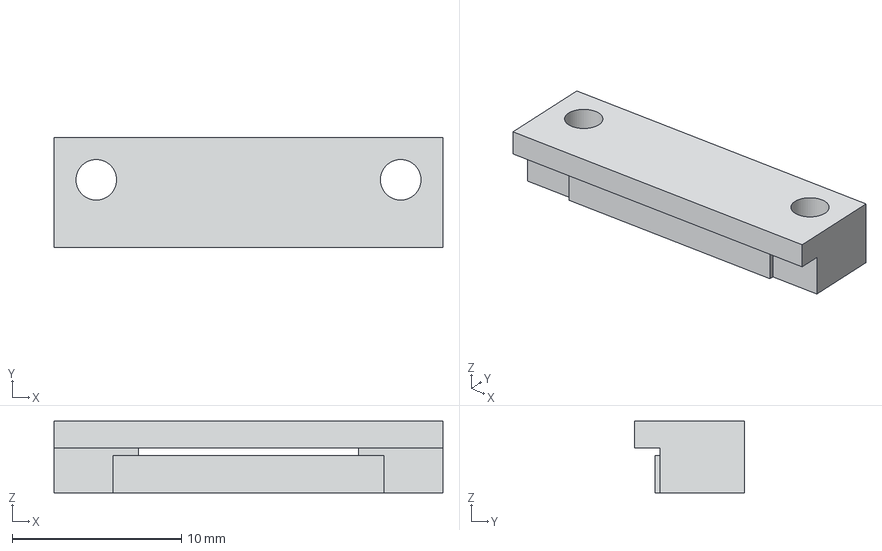
[picture p78: CAD file, 2026-10-22]
cad/compact/mcu_strap.step
23.0 x 6.50 x 4.25 mm
