Avanger2512/macropad/cad/print/MiddleCarrier_Through_Pin_V5.stl

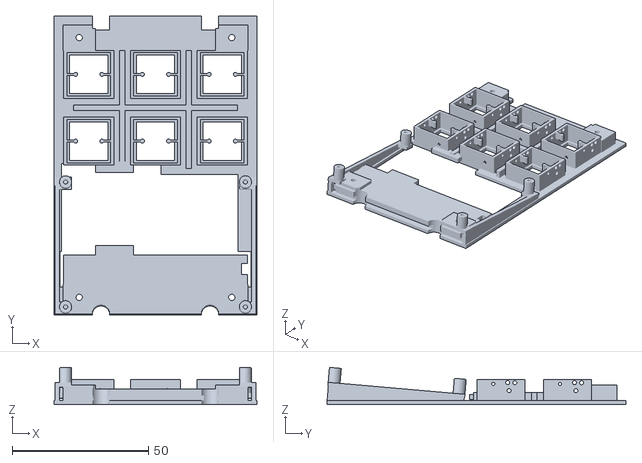
[picture p79: CAD file, 2026-10-20]
cad/print/MiddleCarrier_Through_Pin_V5.stl
74.4 x 109.7 x 13.7
