Avanger2512/macropad/cad/fusion/exports/switch_fit_coupon_through_pin_v5.step

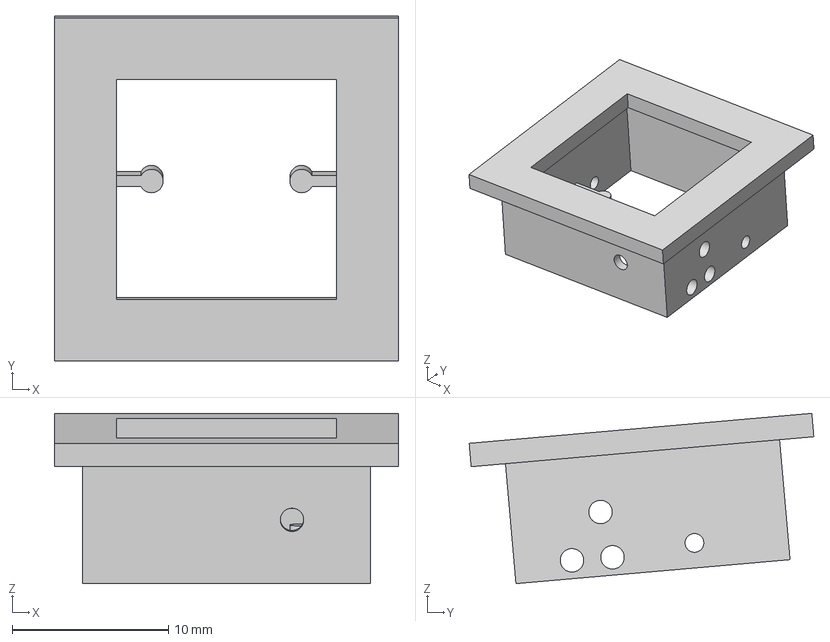
[picture p80: CAD file, 2026-10-20]
cad/fusion/exports/switch_fit_coupon_through_pin_v5.step
22.0 x 22.0 x 10.9 mm
