Avanger2512/macropad/cad/print/SwitchFitCoupon_Through_Pin_V5.stl

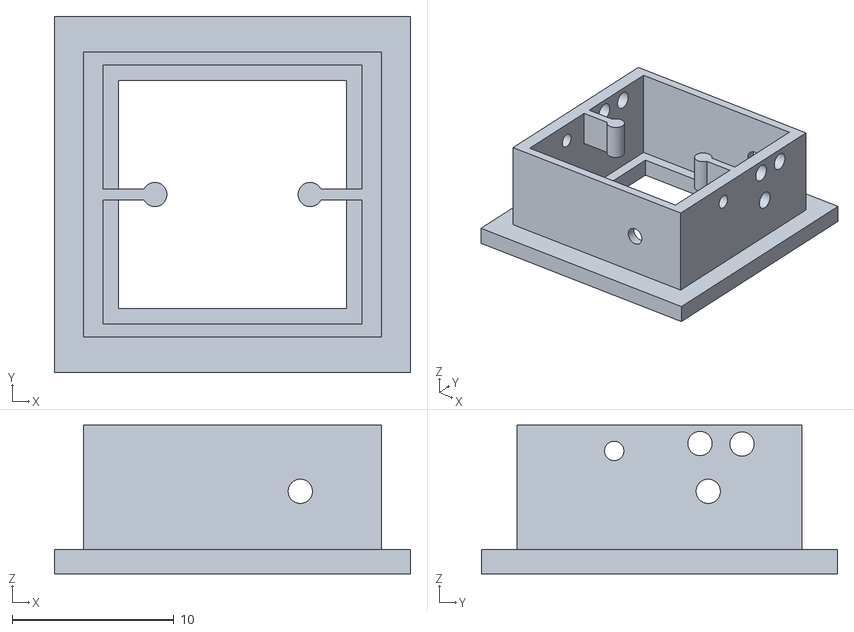
[picture p81: CAD file, 2026-10-20]
cad/print/SwitchFitCoupon_Through_Pin_V5.stl
22.0 x 22.0 x 9.20
