Avanger2512/macropad/cad/print/Hotswap_MX_Through_Pin_V5.stl

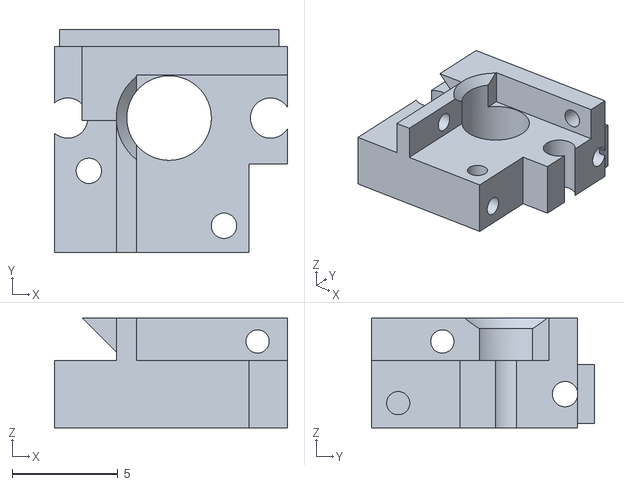
[picture p82: CAD file, 2026-10-20]
cad/print/Hotswap_MX_Through_Pin_V5.stl
11.0 x 10.6 x 5.20
