Avanger2512/macropad/cad/fusion/exports/macropad_service_v9.step

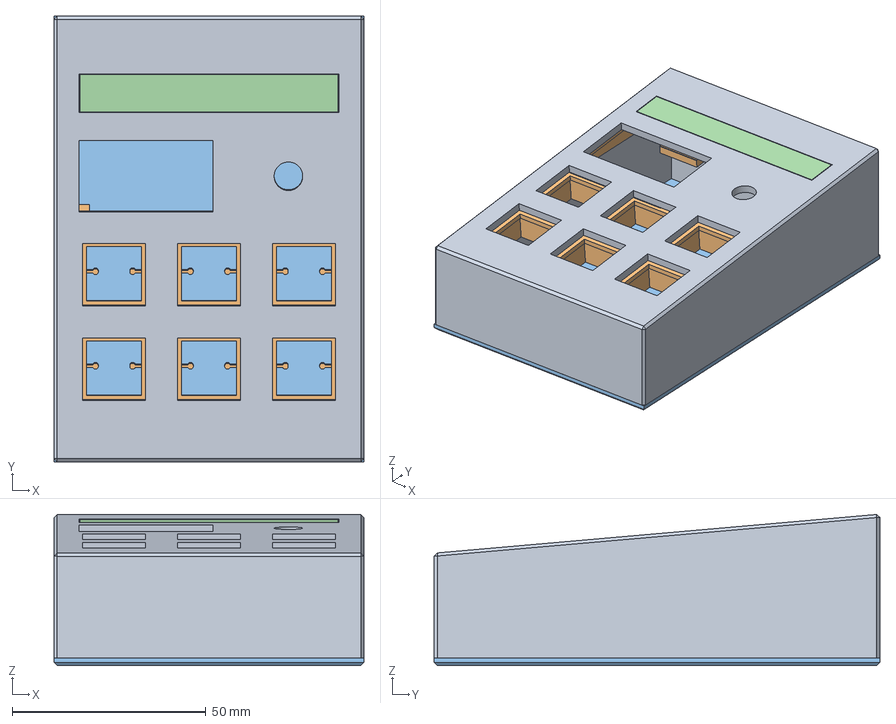
[picture p83: CAD file, 2026-10-20]
cad/fusion/exports/macropad_service_v9.step
80.0 x 115.0 x 39.0 mm
