Avanger2512/macropad/cad/print/MiddleCarrier_Draft(test).stl

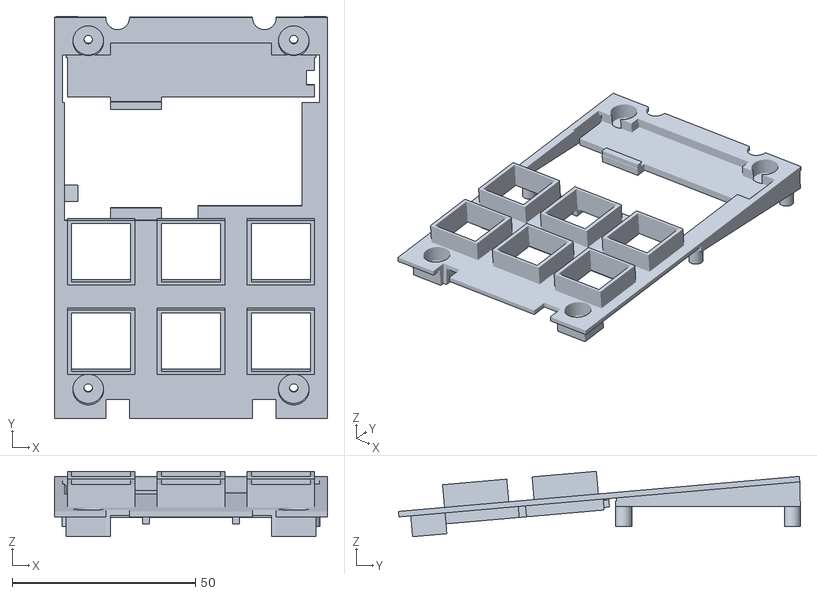
[picture p84: CAD file, 2026-10-13]
cad/print/MiddleCarrier_Draft(test).stl
74.4 x 109.6 x 17.8
