Avanger2512/macropad/cad/fusion/exports/macropad_enclosure_finish_v6.step

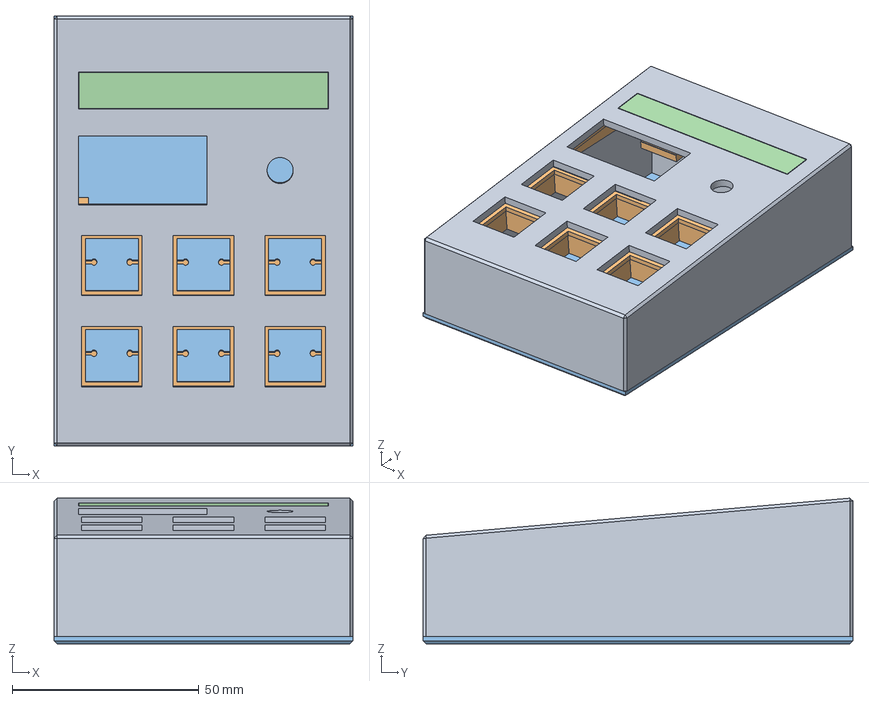
[picture p85: CAD file, 2026-10-20]
cad/fusion/exports/macropad_enclosure_finish_v6.step
80.0 x 115.0 x 39.0 mm
