Avanger2512/macropad/cad/print/hotswap_mx__compact_REFERENCE_V2.stl

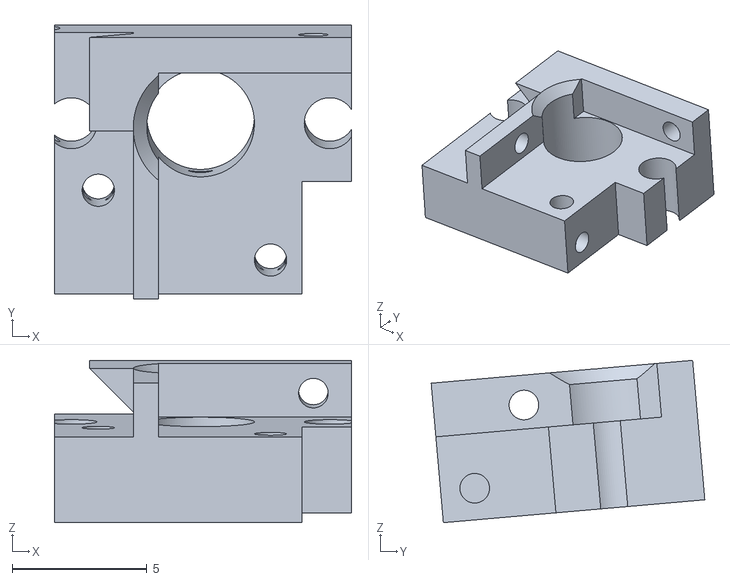
[picture p86: CAD file, 2026-10-13]
cad/print/hotswap_mx__compact_REFERENCE_V2.stl
11.0 x 10.2 x 6.03
