Avanger2512/macropad/cad/print/SwitchFitCoupon_Compact_V2(v2).stl

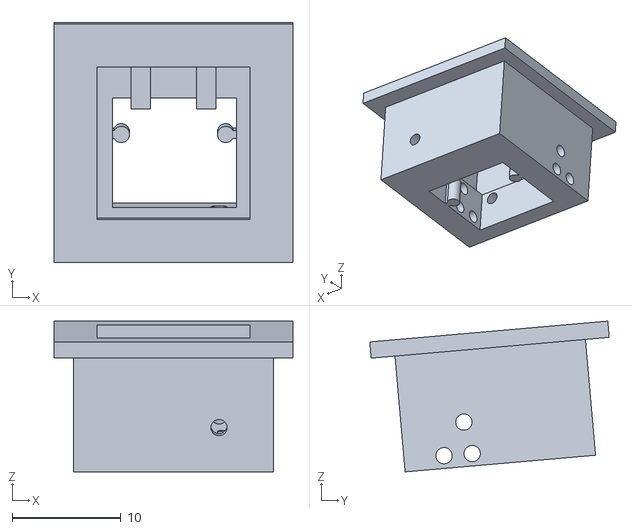
[picture p87: CAD file, 2026-10-13]
cad/print/SwitchFitCoupon_Compact_V2(v2).stl
22.0 x 22.0 x 13.9
