Avanger2512/macropad/cad/print/LidSupportCoupon_Compact_V3.stl

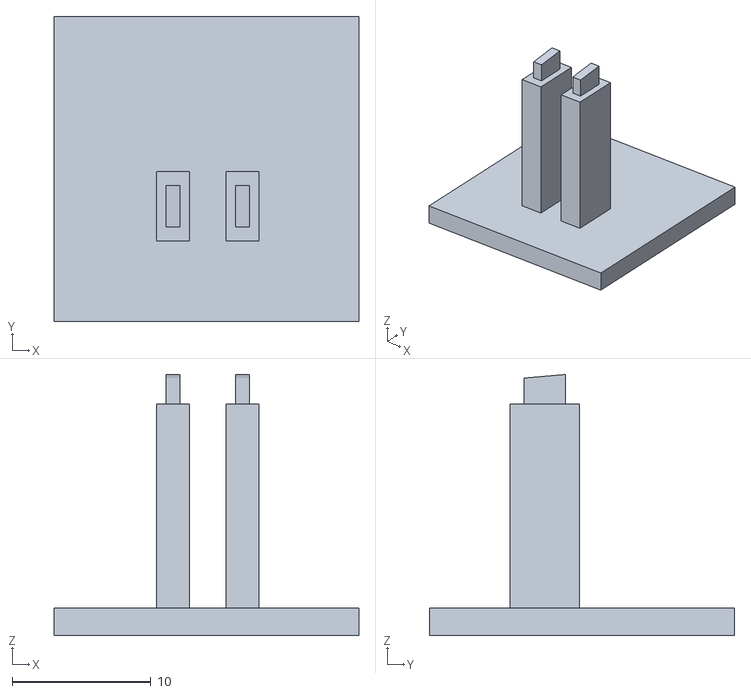
[picture p88: CAD file, 2026-10-13]
cad/print/LidSupportCoupon_Compact_V3.stl
22.0 x 22.0 x 18.8
