Avanger2512/macropad/cad/fusion/exports/diffuser_service_v9_native.stl

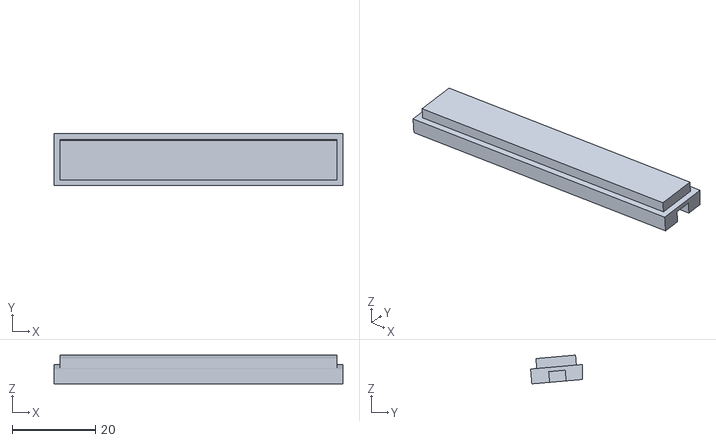
[picture p89: CAD file, 2026-10-20]
cad/fusion/exports/diffuser_service_v9_native.stl
69.6 x 12.5 x 6.94
