Avanger2512/macropad/cad/print/SwitchFitCoupon_Trial.stl

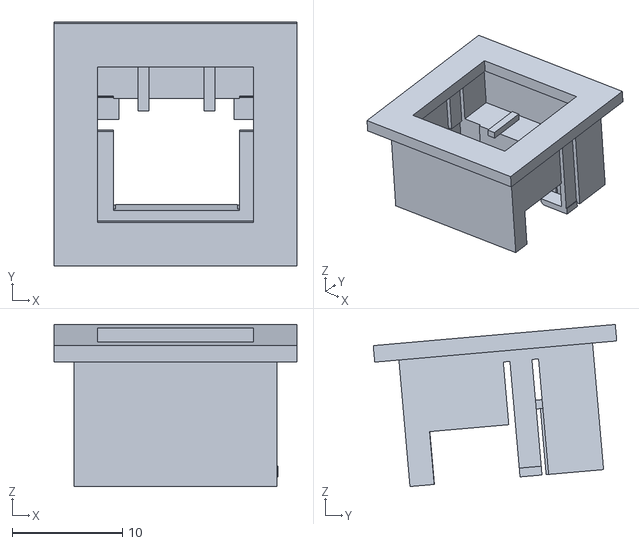
[picture p90: CAD file, 2026-10-13]
cad/print/SwitchFitCoupon_Trial.stl
22.0 x 22.0 x 14.7
