Avanger2512/macropad/cad/print/LidSupportCoupon_Trial.stl

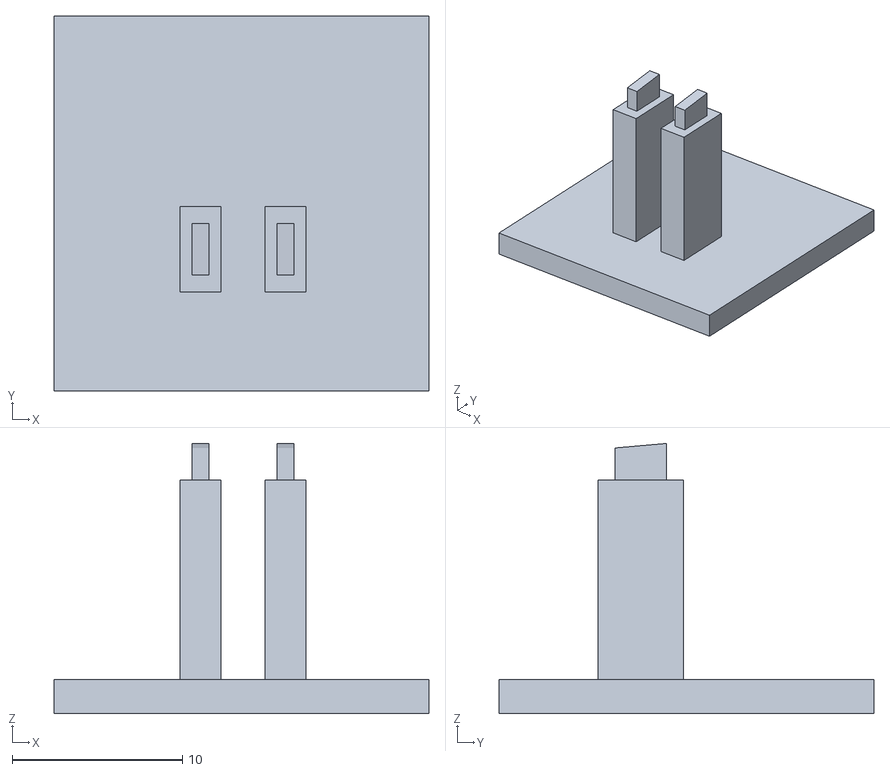
[picture p91: CAD file, 2026-10-13]
cad/print/LidSupportCoupon_Trial.stl
22.0 x 22.0 x 15.8
