Avanger2512/macropad/cad/fusion/exports/macropad_enclosure_pcb_revision.step

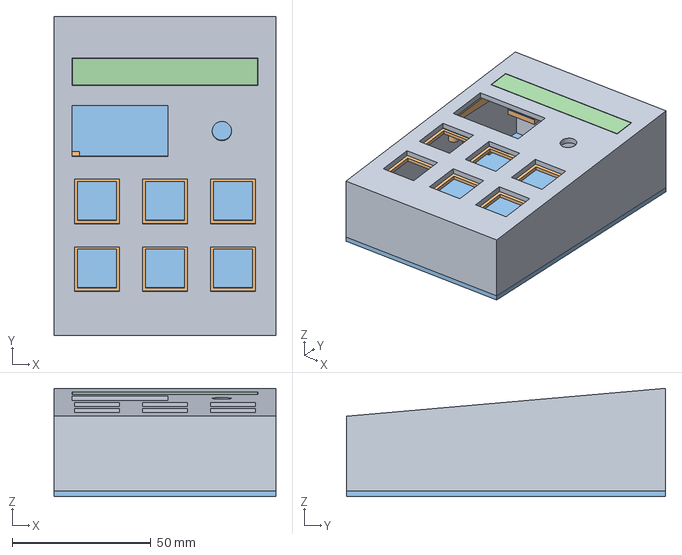
[picture p92: CAD file, 2026-10-13]
cad/fusion/exports/macropad_enclosure_pcb_revision.step
80.0 x 115.0 x 39.1 mm
