Avanger2512/macropad/cad/fusion/exports/switch_fit_coupon.stl

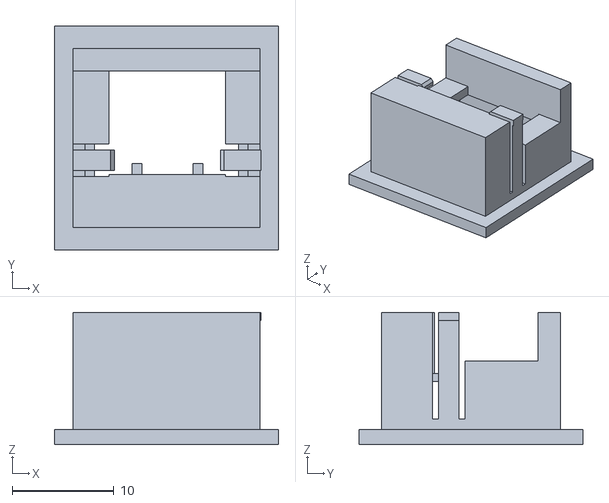
[picture p93: CAD file, 2026-10-13]
cad/fusion/exports/switch_fit_coupon.stl
22.0 x 22.0 x 13.0
