Avanger2512/macropad/cad/fusion/exports/macropad_enclosure_draft.step

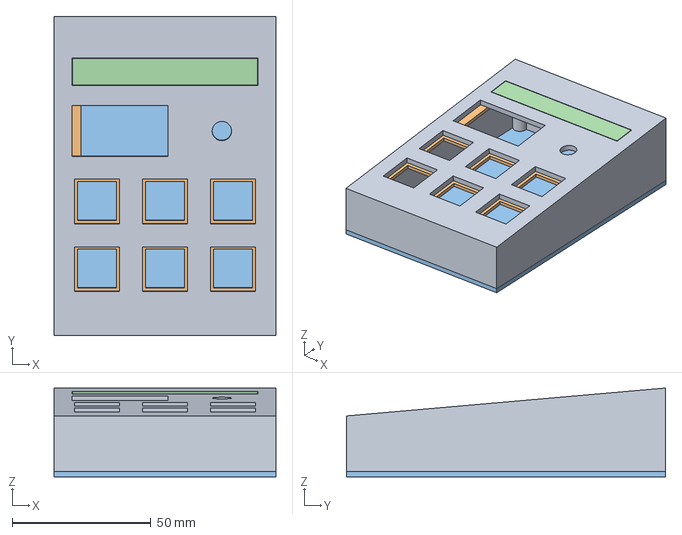
[picture p94: CAD file, 2026-10-13]
cad/fusion/exports/macropad_enclosure_draft.step
80.0 x 115.0 x 32.1 mm
