Avanger2512/macropad/cad/fusion/exports/macropad_switch_retention_with_trials.step

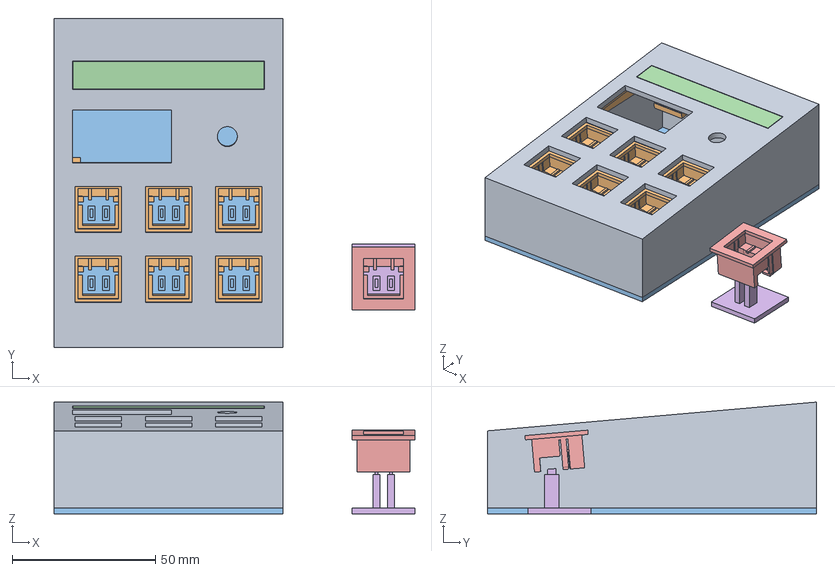
[picture p95: CAD file, 2026-10-13]
cad/fusion/exports/macropad_switch_retention_with_trials.step
126.0 x 115.0 x 39.1 mm
