Avanger2512/macropad/cad/fusion/exports/macropad_enclosure_iteration4.step

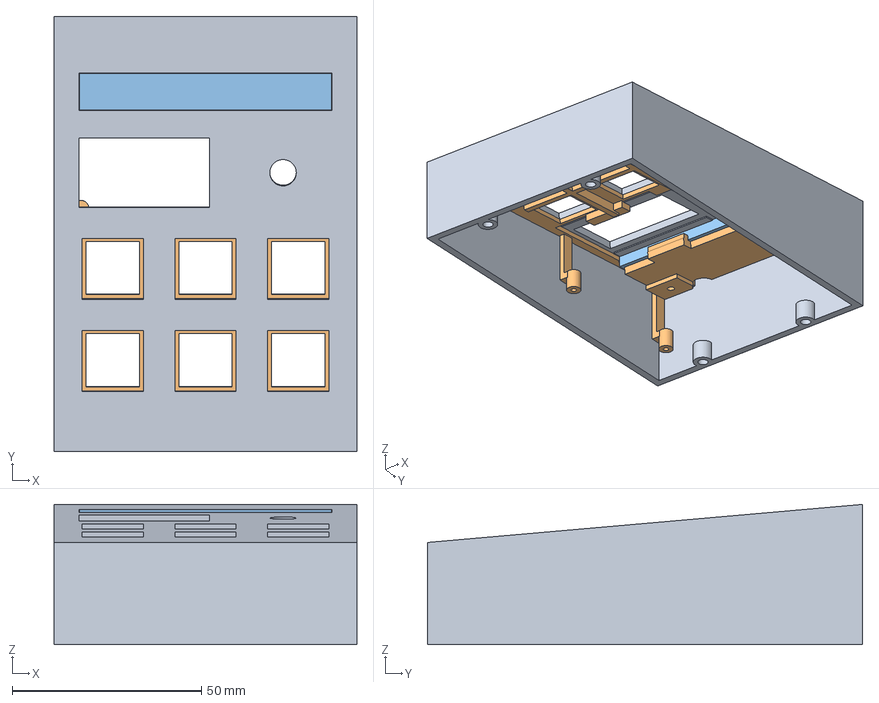
[picture p96: CAD file, 2026-10-13]
cad/fusion/exports/macropad_enclosure_iteration4.step
80.0 x 115.0 x 37.1 mm
