Avanger2512/macropad/(list of files, cad)

Other CAD files:
cad/compact/c5/top_shell.step
cad/compact/top_shell.step
cad/print/top_shell_FINAL.step
cad/compact/c2/oled_fit_coupon.step
cad/compact/c3/oled_fit_coupon.step
cad/compact/c3/top_shell.step
cad/print/BottomCover_Finish_V6.stl
cad/fusion/exports/bottom_cover_finish_v6_native.stl
cad/print/UpperShell_Finish_V6.stl
cad/compact/c2/oled_cradle.step
cad/compact/oled_fit_coupon.step
cad/fusion/exports/upper_shell_service_v9.step
cad/compact/bottom_cover.step
cad/print/UpperShell_Cover_Mounts_V7.stl
cad/fusion/exports/switch_fit_coupon_through_pin_v5_native.stl
cad/fusion/exports/upper_shell_service_v9_native.stl
cad/print/UpperShell_Service_V9.stl
cad/print/SwitchFitCoupon_Compact_V4.stl
cad/fusion/exports/upper_shell_cover_mounts_v7_native.stl
cad/print/Hotswap_MX_Compact_Pin_V4.stl
cad/fusion/exports/middle_carrier_through_pin_v5.step
cad/fusion/exports/macropad_cover_mounts_v7.step
cad/print/MiddleCarrier_Compact_V4.stl
cad/fusion/exports/upper_shell_finish_v6_native.stl
cad/fusion/exports/upper_shell_cover_mounts_v7.step
cad/fusion/exports/diffuser_service_v9.step
cad/fusion/exports/hotswap_mx_through_pin_v5.step
cad/fusion/exports/switch_fit_coupon_compact_v4_native.stl
cad/fusion/exports/middle_carrier_compact_v4_native.stl
cad/fusion/exports/lid_support_coupon_compact_v3.step
cad/fusion/exports/switch_fit_coupon_compact_v4.step
cad/fusion/exports/hotswap_mx_compact_pin_v4.step
cad/fusion/exports/middle_carrier_compact_v4.step
cad/fusion/exports/hotswap_mx_compact_pin_v4_native.stl
cad/fusion/exports/lid_support_coupon_compact_v3_native.stl
cad/fusion/exports/compact_reference_aligned_v4.stl
cad/fusion/exports/lid_support_coupon.stl
cad/compact/accessories/rear_feet/bottom_cover_with_feet.f3d
cad/compact/accessories/rear_feet/bottom_cover_with_feet.stl
cad/compact/accessories/rear_feet/c4_with_rubber_feet.f3d
cad/compact/accessories/rear_feet/feet_set.stl
cad/compact/accessories/rear_feet/front_foot.stl
cad/compact/accessories/rear_feet/rear_foot.stl
cad/compact/c2/compact_c2_flush.f3d
cad/compact/c2/oled_fit_coupon.stl
cad/compact/c3/compact_c3_flush.f3d
cad/compact/c3/oled_fit_coupon.stl
cad/compact/c4/bottom_cover.stl
cad/compact/c4/compact_c4_fit.f3d
cad/compact/c4/mx_coupon.stl
cad/compact/c4/top_shell.stl
cad/compact/c5/top_shell.f3d
cad/compact/c5/top_shell.stl
cad/compact/compact_c1_oled_31x28.f3d
cad/compact/mx_coupon.stl
cad/compact/oled_fit_coupon.stl
cad/fusion/exports/compact_reference_aligned_v2.stl
cad/fusion/exports/compact_reference_aligned_v3.stl
cad/fusion/exports/diffuser_service_v8.step
cad/fusion/exports/macropad_before_carrier_v4.f3d
cad/fusion/exports/macropad_before_compact_v2.f3d
cad/fusion/exports/macropad_before_compact_v3.f3d
cad/fusion/exports/macropad_before_compact_v4.f3d
cad/fusion/exports/macropad_before_cover_mounts_v7.f3d
cad/fusion/exports/macropad_before_enclosure_finish_v6.f3d
cad/fusion/exports/macropad_before_front_cleanup_v9.f3d
cad/fusion/exports/macropad_before_service_clearance_v8.f3d
cad/fusion/exports/macropad_before_through_pin_v5.f3d
cad/fusion/exports/macropad_carrier_compact_v4.f3d
cad/fusion/exports/macropad_compact_trial_v2.f3d
cad/fusion/exports/macropad_compact_trial_v3.f3d
cad/fusion/exports/macropad_compact_trial_v4.f3d
cad/fusion/exports/macropad_cover_mounts_v7.f3d
cad/fusion/exports/macropad_enclosure_before_pcb_revision.f3d
cad/fusion/exports/macropad_enclosure_draft.f3d
cad/fusion/exports/macropad_enclosure_finish_v6.f3d
cad/fusion/exports/macropad_enclosure_iteration1.f3d
cad/fusion/exports/macropad_enclosure_iteration1.step
cad/fusion/exports/macropad_enclosure_iteration2.f3d
cad/fusion/exports/macropad_enclosure_iteration2.step
cad/fusion/exports/macropad_enclosure_iteration3.f3d
cad/fusion/exports/macropad_enclosure_iteration4.f3d
cad/fusion/exports/macropad_enclosure_pcb_revision.f3d
cad/fusion/exports/macropad_retention_before_registration_fix.f3d
cad/fusion/exports/macropad_service_v8.f3d
cad/fusion/exports/macropad_service_v8.step
cad/fusion/exports/macropad_service_v9.f3d
cad/fusion/exports/macropad_switch_retention_with_trials.f3d
cad/fusion/exports/macropad_through_pin_v5.f3d
cad/fusion/exports/switch_fit_coupon_compact_v2.step
cad/fusion/exports/switch_fit_coupon_compact_v3.step
cad/fusion/exports/switch_fit_coupon_compact_v3_native.stl
cad/fusion/exports/upper_shell_service_v8.step
cad/fusion/exports/upper_shell_service_v8_native.stl
cad/print/SwitchFitCoupon_Compact_V2.stl
cad/print/SwitchFitCoupon_Compact_V3.stl
cad/print/UpperShell_Service_V8.stl
cad/print/bottom_cover_with_feet_FINAL.f3d
cad/print/bottom_cover_with_feet_FINAL.stl
cad/print/top_shell_FINAL.f3d
cad/print/top_shell_FINAL.stl
