Avanger2512/macropad/cad/print/README_FINAL.md

# Final enclosure print set

- `top_shell_FINAL.stl`: C5, full OLED34.5×23 in34.9×23.4 throat;
  face flush using measured2mm height above PCB, margins6/4.6mm.
  MX14mm, clip seat1.5mm; ESP rows15mm and slots1.8×20.8mm.
  Insert boresØ3.2×5.5mm for5mm inserts. Orient outer roof onto bed.
- `bottom_cover_with_feet_FINAL.stl`: cover with four integral feet,
  reinforced45° bases and Ø10.3×0.4 seats for four Ø10×2 rubber pads.
  Rear rise6mm, slope6.1155°. Print flat inner face down, feet up.

STEP and F3D equivalents accompany each STL. Files are byte-identical copies
of checked source exports; `enclosure_FINAL.json` records hashes and sources.
Sources and validation: `../compact/c5/README.md` and
`../compact/accessories/rear_feet/README.md`. Physical final fit untested.
