Avanger2512/macropad/cad/compact/c2/previews/c2-fusion-assembly.png

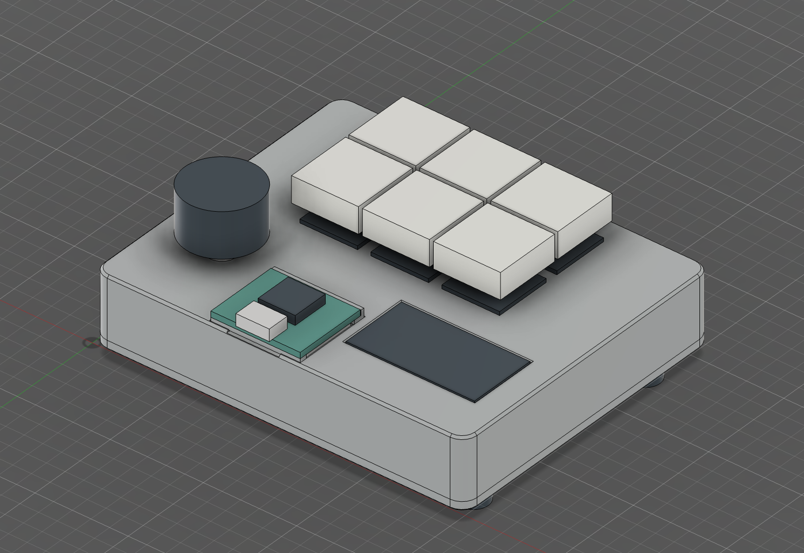
cad/compact/c2/previews/c2-fusion-assembly.png
