Avanger2512/macropad/cad/compact/c3/previews/c3-assembly-front_20261022T103931Z.png

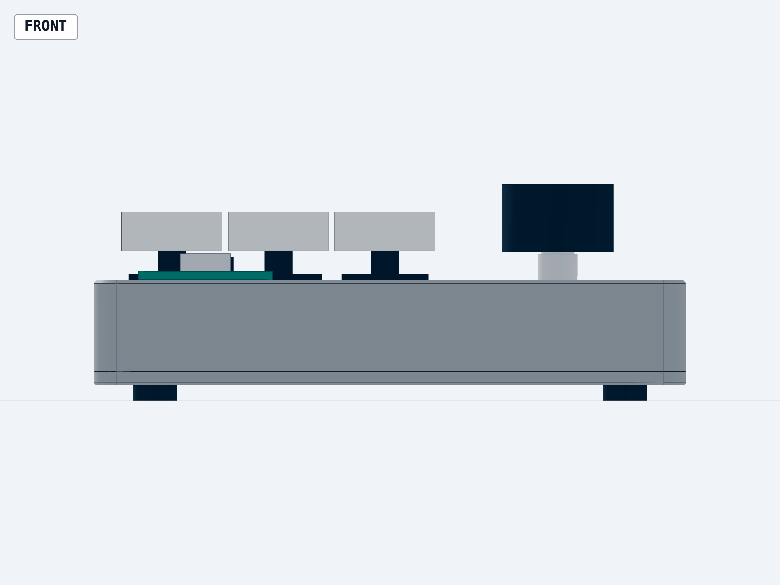
cad/compact/c3/previews/c3-assembly-front_20261022T103931Z.png
