Avanger2512/macropad/cad/compact/c3/previews/c3-fusion-assembly.png

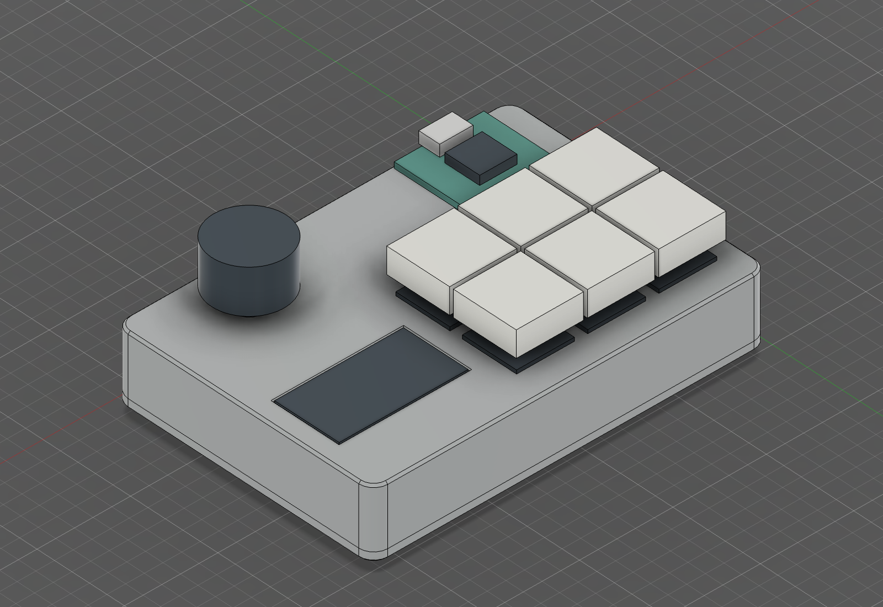
cad/compact/c3/previews/c3-fusion-assembly.png
