Avanger2512/macropad/cad/compact/previews/c1-oled-fusion-assembly.png

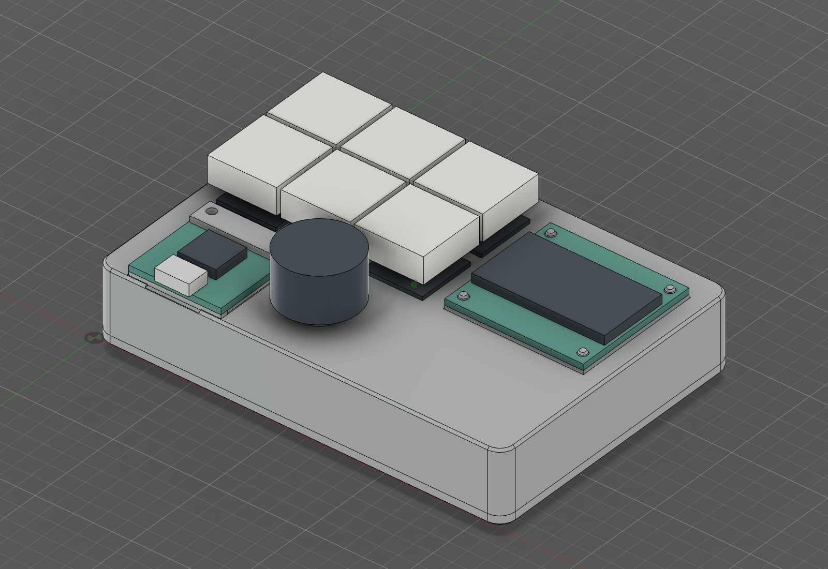
cad/compact/previews/c1-oled-fusion-assembly.png
