Avanger2512/macropad/cad/fusion/exports/compact-v3-assembled.png

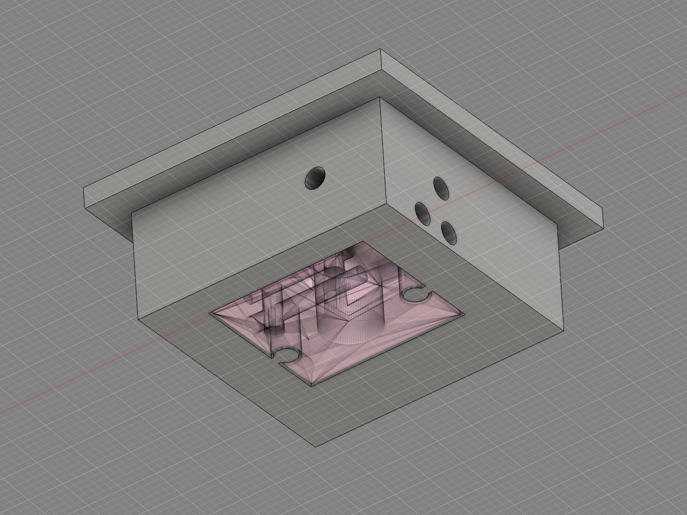
cad/fusion/exports/compact-v3-assembled.png
