Avanger2512/macropad/cad/fusion/exports/through-pin-v5-assembled.png

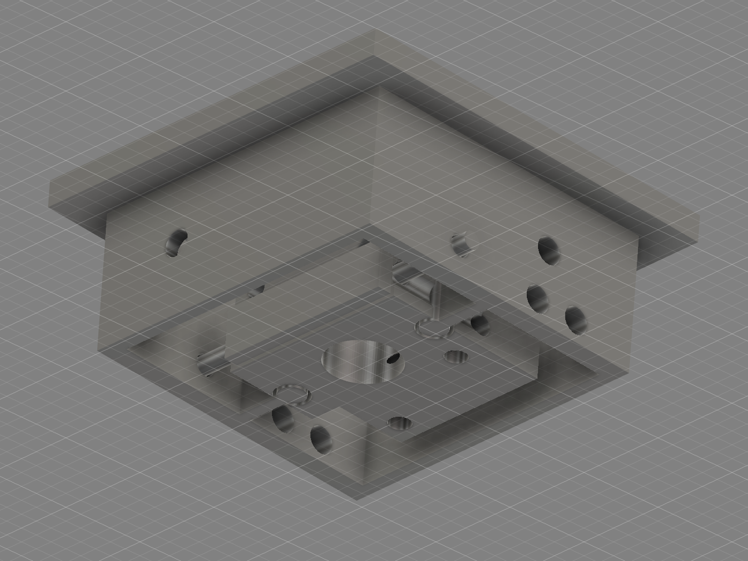
cad/fusion/exports/through-pin-v5-assembled.png
