Avanger2512/macropad/(list of files, drawings)

Other design files:
cad/fusion/exports/pcb-layout-validation.json
