Avanger2512/macropad/(commit log)

2026-10-12 main chore: import tested firmware and organize CAD assets
    - Preserve tested ESP32-S3 firmware and input logic tests
    - Organize STL and 3MF models under cad
    - Add component list, wiring, build instructions and verification report
    - Document project structure and license scope in README
    [MX.stl, choc.stl, hotswap_mx__with_wing.stl, whotswap-MX-v2.3mf]
2026-10-12 main docs: translate project text into English
    - Translate all seven Markdown documents into English
    - Preserve build commands, wiring details and verification results
    - Translate the 3MF slicer profile label without changing model geometry
    [whotswap-MX-v2.3mf]
2026-10-13 main feat: add Fusion enclosure prototype and bolt-free switch holders
    - Add parametric enclosure iterations with revised PCB mounts and OLED retention
    - Add hollow diffuser, LED support, snap-fit holder receivers and lid supports
    - Export STEP/F3D prototypes, trial STL meshes and Fusion screenshots
    - Verify holder mesh registration and prepare bed-oriented trial meshes
    - Document measured dimensions, print sequence and remaining physical fit checks
    [LidSupportCoupon_Trial.stl, SwitchFitCoupon_Trial.stl, lid_support_coupon.stl, lid_support_coupon_native.stl, macropad_enclosure_before_pcb_revision.f3d, macropad_enclosure_draft.f3d, macropad_enclosure_draft.step, macropad_enclosure_iteration1.f3d]
2026-10-13 main feat: integrate tested compact V4 switch receivers
    - Preserve compact V2, V3 and V4 fit trials and native Fusion archives
    - Apply tested V4 receivers to all six middle-carrier switch positions
    - Add isolated STEP and print-oriented STL exports with validation reports
    - Document print sequence, pin assembly and remaining enclosure limitations
    - Ignore generated Python bytecode caches
    [Hotswap_MX_Compact_Pin_V4.stl, LidSupportCoupon_Compact_V3.stl, MiddleCarrier_Compact_V4.stl, MiddleCarrier_Draft(test).stl, SwitchFitCoupon_Compact_V2(v2).stl, SwitchFitCoupon_Compact_V2.stl, SwitchFitCoupon_Compact_V3.stl, SwitchFitCoupon_Compact_V4.stl]
2026-10-19 main fix: correct assembled board inputs and document flashing
    - Map physical buttons to verified GPIOs and reverse encoder direction
    - Add GPIO event diagnostics and input mapping regression checks
    - Update wiring and record successful uploads and hardware verification
    - Document repeatable macOS flashing and targeted USB recovery
    [macropad_test.ino, test_inputs.cpp]
2026-10-20 main feat: add RMK Vial firmware with interactive OLED
    - Port the verified ESP32-S3 pin mapping to pinned RMK with persistent Vial configuration
    - Add four editable layers, encoder actions, layer RGB and animated OLED activity feedback
    - Reserve settings storage and document flashing, backup, recovery and Ghostty setup
    - Save initial and current Vial layouts including tab controls and encoder layer switching
    - Add board configuration, flash layout, RGB encoding and display timing checks
    - Record configurator research and deferred Hammerspoon display integration
    [partitions.csv]
2026-10-20 main feat: add Claude and Codex macropad notifications
    - Add dedicated USB HID alerts with source logos and breathing LEDs
    - Install source-aware macOS hooks and a persistent notification toggle
    - Preserve Vial layouts and document setup, recovery, and verification
    - Cover alert protocol, host state, and hook installation with tests
2026-10-20 main feat: finalize enclosure V9 and validated print assets
    - Add V5 through-pin retention sources and preserve the physically fitted middle carrier
    - Add USB and BOOT/RESET access, exterior chamfers, and roof-connected cover mounts
    - Clear the carrier installation path and remove obsolete front triangular supports
    - Export STEP, Fusion archives, bed-oriented STL files, and the V9 print package
    - Record geometry validation, assembly audits, fastener dimensions, and current print instructions
    [BottomCover_Finish_V6.stl, Diffuser_Service_V8.stl, Hotswap_MX_Through_Pin_V5.stl, MiddleCarrier_Through_Pin_V5.stl, SwitchFitCoupon_Through_Pin_V5.stl, UpperShell_Cover_Mounts_V7.stl, UpperShell_Finish_V6.stl, UpperShell_Service_V8.stl]
2026-10-22 feat: add compact enclosure C4 and blue status indication
    - Preserve compact C1-C3 layouts with CAD sources, native exports and validation snapshots
    - Add C4 measured switch, OLED and ESP fit corrections and printable STL parts
    - Replace the separate OLED frame with upper-shell glue mounts and a flat lower cover
    - Add blue onboard notification pulses and one-to-four layer flashes with timing tests
    - Record Fusion geometry checks, mesh validation and confirmed hardware behavior
    [bottom_cover.step, bottom_cover.stl, compact_c1_oled_31x28.f3d, compact_c2_flush.f3d, compact_c3_flush.f3d, compact_c4_fit.f3d, compact_model.step, mcu_cradle.step]
2026-10-24 main feat: finalize enclosure C5 and integral-foot cover
    - Fit complete OLED flush using measured dimensions and update 5 mm insert pockets
    - Add raised feet, integral cover and reinforced base chamfers for 10 mm rubber pads
    - Save checked STL, STEP and Fusion exports with FINAL suffix and checksum manifest
    - Include parametric sources, fit tests, geometry reports and print instructions
    [bottom_cover_with_feet.f3d, bottom_cover_with_feet.step, bottom_cover_with_feet.stl, bottom_cover_with_feet_FINAL.f3d, bottom_cover_with_feet_FINAL.step, bottom_cover_with_feet_FINAL.stl, c4_with_rubber_feet.f3d, feet_set.step]
2026-10-24 main feat: add power LED and colored input notifications
    - Keep the red LED on with explicit GPIO48 SPI and GPIO routing
    - Increase RGB brightness and add green physical key feedback
    - Distinguish Codex and Claude alerts with cyan and orange colors
    - Preserve layer and alert priority and verify unchanged Vial settings
    - Add timing and color regressions and record hardware confirmation
